AjayaDahal/inverted-pendulum/DESIGN.md

# Design

Every number here comes from `scripts/params.py` (geometry) and `parts/sim.json` (dynamics); the
gate (`scripts/check_parts.py`) checks them. Coordinates: x along the rails (+x = idler end, −x =
motor end), y from the front (−) to the back (+), z up from the desk; origin at the centre of the
frame's footprint.

## Key numbers

| | |
|---|---|
| Frame (yours) | 686 × 193 × 319 mm high (your tape and photos), 2020 posts and bottom members, 2040 top end bars on edge |
| Rails (yours) | 2 × 8 mm rods (680 mm or longer) on SK8 supports, 114 mm apart (calipers), axes 339 mm above the desk |
| Carriage | 4 × SC8UU under a 150 × 160 × 8 mm printed plate; 0.90 kg moving, belt and spinning parts included |
| Travel | ±241 mm to the bumpers (482 mm), limit switches trip at ±237, firmware keeps to ±231 |
| Belt | yours: HTD 8M, 20 mm, a closed loop of 175 teeth (1400 mm: your count, and its stamp); both pulleys 20 teeth (pitch Ø 50.93 mm, 160 mm per turn), axles 242 mm up, 620 mm apart |
| Belt length | the axles' spacing follows `BELT_TEETH`; the tensioner then takes 1380–1420 mm (±2.5 teeth); a loop over about 1500 mm (187 teeth) cannot fit inside the end frames |
| Motor | your NEMA 17 at 1.5 A and 19 V: 9.8 N at the cart up to 1 m/s (torque-speed model), 80 % of it relied on; 20.0 steps/mm at 1/16 microstep |
| Friction | rails 0.8 N, belt 0.3 N, greased idler 0.7 N at 15 N belt tension: 1.8 N at the cart; pivot: goal 0.5 mN m |
| Pivot | 8 mm × 115 mm shaft in 2 × KP08, 70 mm apart, axis 385 mm up; the arm turns 8 mm in front of the frame |
| Pendulum | 20 × 10 mm PLA arm, 300 mm from the axis to the tip; 112 g turning, CG 70 mm out, 1.71 × 10⁻³ kg m² about the axis |
| Sensor | AS5600 (12 bit) with a diametric magnet held 5 mm off the steel shaft's end, or a 600 P/R optical encoder |
| Control (model) | kick, swing-up, catch, LQR with integral action: upright in 3.1 s (≤ 4.8 s over 48 robustness runs), cart within ±187 mm; balanced, it hunts 0.1° at the pivot's goal friction |
| Firmware | `firmware/pendulum`: Arduino Uno / Nano or ESP32, FastAccelStepper, 200 Hz |
| Prints | 21 part files, 6 plates, no supports: PLA 364 g / 14.6 h, PETG 248 g / 10.1 h; only the parts you still need: `3mf/to_print_kobra_s1.3mf` |

## Measure first

Your measuring photos (tape and calipers) gave the frame's length and width, the rods' spacing
and the belt; you counted the belt's teeth and taped the frame's height. If any of it changes, put
it in `scripts/params.py`, then run `python scripts/build_all.py`; the gate re-checks every
clearance. The last four rows are catalogue sizes, not yet measured on your parts: measure them
before printing the parts that bolt to them (REPORT.md, R13):

| Name | What | Now | Source, and the slack in the design |
|---|---|---|---|
| `FRAME_H` | desk to the top of the top end bars | 319 | your tape, hook on the desk; everything is placed from the bars |
| `BELT_TEETH` | the closed belt's teeth | 175 | your count; it is stamped 1400 mm at 8 mm pitch. The axles' spacing follows, the tensioner takes ±2.5 teeth |
| `FRAME_L` | length between the end frames' outer faces | 686 | tape; the stops and switches follow it |
| `FRAME_W` | width across the posts' outer faces | 193 | tape; bridge slides ±10 mm: 173–213 wide fit |
| `ROD_SPACING` | rod centre to rod centre | 114 | calipers (122 over the rods' outer faces); SC8UU holes slotted ±8 mm: 98–130 fit |
| `ROD_L` | rod length | 680 | at least this, to reach through both SK8s |
| `BELT` | pitch and width | HTD 8M, 20 | calipers: 20.0–20.6 mm wide; its teeth 8 mm apart |
| `SC8UU` | one block's screw holes, centre to centre: along the rod, across it | 18, 24 (M4) | catalogue; your old plate's photo agrees. `carriage_plate`: fixed along the rod, ±8 mm across |
| `SK8`, `SC8UU` | rod centre above the end bar's top; the block's top face above the rod centre | 20, 11 | catalogue; they set the plate's height, so where the clamp's jaw meets the belt |
| `KP08` | bolt holes centre to centre; base to shaft centre | 42, 15 | catalogue. `pivot_bridge`: fixed M5 holes; the KP08's own slotted feet take a little |
| `ENDSTOP` | the limit-switch board's two holes, centre to centre | 19 | catalogue. `switch_mount`: ±1 mm |

## How the belt runs now

Cut on the belt plane: motor pulley at the left, idler at the right, the clamp column from the carriage down to the upper run

The belt is a vertical loop in **one plane, the frame's centre line (y = 0)**, round two equal
pulleys whose axles sit at the **same height (z 242)**, so both runs are level and parallel to the
rails, and the clamp grips the upper run in that same plane, under the carriage's centre (no twist
on the carriage). The pulleys hang from the 2040 top end bars, spaced for your closed loop:
`BELT_TEETH` sets the axles' spacing (620 mm for 175 teeth), so each sits 23 mm inboard of its end
frame's centre line, near where yours were.

**Motor end** (`motor_mount`, PETG). A saddle wraps the −x top end bar from below: a cheek on each
of its 40 mm faces (two M5 + T-nuts each) and a web under it, reaching in to the motor. The motor
hangs under the web, its
face on a 7 mm plate with the four M3 heads sunk 3.2 mm so the pulley's back flange (1 mm away)
clears them, between two side walls and on a floor: it cannot twist under belt pull. The shaft
points forward to the pulley; the body sits behind (+y), clear of the carriage.

**Pulleys** (`motor_pulley`, `idler_pulley`, PETG). 20 teeth, HTD 8M grooves (circular, 3.5 mm deep),
22 mm toothed width for the 20 mm belt, a 30 mm flange printed on each and a second flange
(`pulley_flange`) pressed on the front boss after assembly, so the belt has a flange on both sides
with 1 mm to spare. The motor pulley has a D bore whose flat faces a radial M3 × 12 set screw: its
head is sunk below the teeth, its nut captive in a slot under the front flange. Tighten it before
pressing the flange on. The idler turns on `idler_sleeve`.

**Idler end** (`idler_mount`, `idler_slider` × 2, PETG). The same saddle on the +x top end bar,
bolted through its outer cheek only (four M5 into T-nuts in the bar's outer slots). Its web reaches
in 29 mm to two cheeks either side of the idler, held by a 45° gusset from the saddle's inner
cheek, so the web prints (upside down) without supports. Each cheek has a window in which a slider
runs along x (its lower edge, printed last as a 32 mm bridge, has 1 mm of room for the bridge's
sag; the tension screw holds the slider at its height); the M4 × 50 axle passes slider – sleeve –
slider (an M5 × 50 fits too, once the sliders' holes and the sleeve's bore are drilled out to
5.2 mm). An M3 × 30 from an outboard lug
into each slider pulls it out. A closed loop cannot be tightened at the clamp: the idler does it,
and every millimetre the sliders move out takes up 2 mm of belt. Their ±10 mm of travel takes
loops of 1380–1420 mm (175 ± 2.5 teeth).

1. Grease the sleeve (a drop of any grease or oil: it is a plain bearing). Leave the axle nut
   finger-tight. Turn both tension screws evenly, a quarter turn at a time once the slack is out,
   until 100 g hung from the middle of the lower run pulls it down a further 10 mm (200 g: 20 mm).
   Measure from where the run hangs without the weight: its own weight already sags it about 4 mm.
   That is 15 N: enough, as the belt only has to stay taut under the motor's largest pull (~5 N
   each side); more only loads the idler's plain bearing, which the motor then has to drag
   (REPORT.md, P2).
2. Run the cart by hand from end to end. If the belt creeps towards one flange, give that side's
   screw a quarter turn more (the axle squares itself to the belt) and repeat.
3. Tighten the axle nut: it clamps the sliders' flanges against the cheeks. The sleeve takes the
   clamping, so the pulley still turns freely. Check the 100 g test again after the first hour of
   running, while the belt beds in.

**Clamp** (`belt_clamp` PLA, `clamp_jaw` PETG). The upper run is 81 mm below the carriage plate, so
the clamp is a box column (40 × 24 mm, 3 mm walls, flared into the jaw seat on all four sides: 45°
along the belt, 31° across) on four M3 × 16
from the plate's top. The belt lies in a 21 mm channel under a flat ceiling on its back; the jaw
comes up from below with HTD 8M tooth seats in phase with the belt's teeth (nearly 9 along its
70 mm) and pulls up on four M3 × 12 into nuts in the column's side walls. Your closed loop passes
straight through (an open belt would go in from both ends, about 30 mm each). Nothing slips and
there is no play between the cart and the belt.

**Lower run** passes 31 mm under the jaw's screw heads. The cart never reaches the pulleys: the
SC8UU blocks stop on the bumpers first.

## Carriage

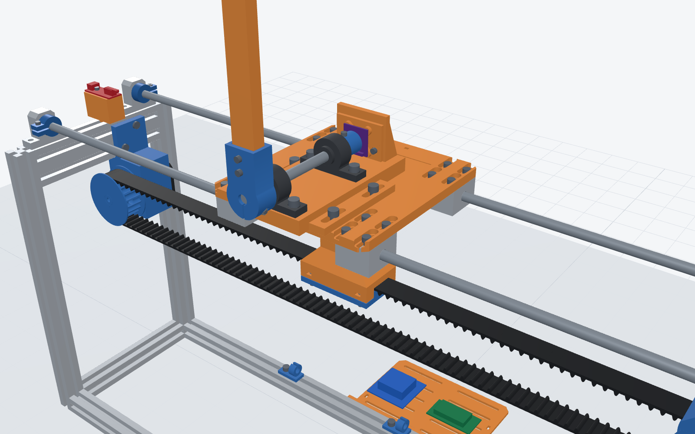
[picture p12: renders/08_carriage.png]
Carriage: plate on four SC8UU blocks, the pivot bridge with both KP08s, the sensor tower, the hub and arm in front


- `carriage_plate` (PLA, 8 mm): four SC8UU blocks underneath (16 × M4 × 10, heads sunk; holes
  slotted ±8 mm in y so the plate fits rods 98–130 mm apart without binding: set the blocks on the
  rods, then tighten). Four M5 nuts in pockets underneath take the bridge; four M3 counterbores take
  the clamp. Two zip-tie bridges at the back edge hold the sensor lead. It is nearly square: the
  lines engraved in its top face go over the rods and its arrow points to the front.
- `pivot_bridge` (PLA): carries both KP08s in line (4 × M5 × 16, nuts in pockets underneath), the
  front one over the plate's front edge. Its side flanges are slotted ±10 mm (4 × M5 × 20): slide it
  until the arm turns 8 mm in front of the frame's front face. At its back end the 5 mm **sensor
  tower** stands on the shaft's axis.

## Pendulum

- Shaft: 8 mm × 115 mm steel, through both KP08s (their set screws hold it) into the hub.
- `pendulum_hub` (PETG): split below the bore, one M3 × 20 pinch screw; the arm in a 25 mm socket
  with 2 × M3 × 20 through. The socket's front face prints as a bridge, so it stands 0.8 mm off the
  arm (0.2 elsewhere), room for that bridge's sag: the two screws pull it onto the arm.
- `pendulum_arm` (PLA, prints diagonally): 20 × 10 mm, its 20 mm in the plane it swings in;
  `pendulum_tip` caps it (M3 × 20 pin; room for washers if you want more tip mass: re-run `sim.py`
  with the new mass).
- It turns a full circle at every cart position: the hub, arm and tip stay in front of the frame
  (y −118 to −100) and the tip clears the desk by 83 mm when it hangs (gate: `pendulum`).
- **Pivot friction** decides how still it balances. While the pivot's bearings stick, the pendulum
  moves with the cart, so a balanced pendulum hunts once the pivot's friction passes about
  0.5 mN m: 0.9° and 17 mm peak to peak at 1 mN m, 4° and 88 mm at 2.5 (REPORT.md, P16). The
  swing-up copes with up to 2.5 mN m; the goal is 0.5 mN m (0.1°, 2 mm). Two KP08 inserts with
  rubber seals are often 1-2 mN m, so before the first run:
  - free the inserts: pry the seals off (a small screwdriver under the lip), wash the grease out
    with isopropyl alcohol, one drop of light oil;
  - loosen the KP08 bolts and re-tighten them with the shaft turning (the two blocks in line);
    the set screws must not push the shaft off-centre;
  - measure with the firmware's `f` test (lift the pendulum 30-40°, let go): it prints the
    friction and the hunting to expect, and re-centres hanging on the true vertical. By eye,
    0.5 mN m is about 20 full swings from 30° before it stops; 2.5 mN m, 4.
- **Keep clear:** the arm sweeps a 600 mm circle in front of the frame at any cart position: x
  ±544 mm, 63 to 670 mm above the desk, and its tip reaches 4 m/s. Nothing in that disc while it
  runs; keep the power switch in reach.

## Angle sensor

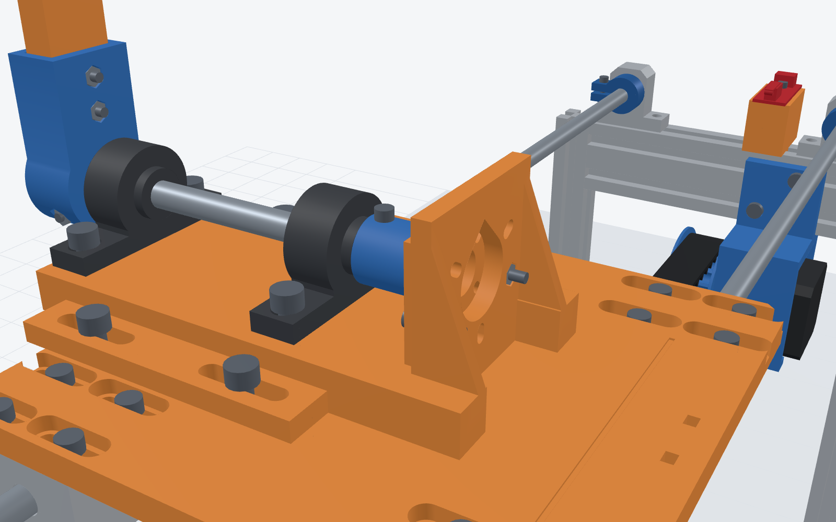
[picture p13: renders/09_sensor.png]
Sensor tower: the AS5600 board on its adapter, facing the magnet cap on the shaft's end


**AS5600 (default).** `magnet_cap` (PETG) goes on the shaft's back end (M3 × 8 set screw) with the
6 × 2.5 mm diametric magnet glued in its pocket, on the axis, 5 mm of plastic away from the
shaft's end: steel close behind the magnet pulls its field in, and the reading gets weaker and
less linear (REPORT.md, P7). `as5600_mount` (PLA) bolts to the
tower's front face (2 × M3 × 12, nuts in the tower's back) and carries the board on four raised,
slotted pads (M2.5 self-tapping, or M3, in the board's corner holes, 18–26 mm apart), chip
towards the magnet, 1.5 mm air gap. Solder its header facing forward (or use the side pads), and
tie its DIR pin to GND: left floating on some boards, it flips the angle's direction at random.

**600 P/R optical encoder (option).** Leave out the cap and the adapter; bolt the encoder to the
tower's back face (3 × M3 into its holes on a 28–32 mm circle, its boss through the tower's
window) and join the shafts with `coupler` (PETG, slotted beam coupling: it takes up the
misalignment between the KP08s and the encoder's bearings). The viewer's "optical encoder" button
shows it.

## Travel ends and homing

`rod_bumper` collars (4, PETG, M3 × 12 clamp) sit against the SK8s' inner faces (further in, if a
short belt brings the pulleys in): the SC8UU blocks stop on them at ±241 mm. A `switch_mount` on
each top end bar (one M5 into a T-nut, keyed in the bar's top slot, inboard of the SK8) holds a
mechanical endstop level with the plate; its roller trips at ±237 mm.

Homing: move −x slowly to the −x switch, back off 5 mm, set x = −232 (the trip point plus the
back-off); then centre. Keep the controller within ±231 mm.

## Control

The model (`scripts/sim.py`) is the cart-pole of this machine: cart 0.68 kg + belt 0.18 kg + motor
rotor and pulleys 0.03 kg reflected = 0.90 kg; pendulum 112 g with its CG 70 mm from the axis and
1.71 × 10⁻³ kg m² about it (sliced masses, steel shaft, screws). Natural frequency 6.7 rad/s. The
firmware runs the same controller (`firmware/pendulum/controller.h`, line for line: the gate
replays simulated runs through it and requires the same commands).

- **Input = cart acceleration,** at most 3.54 m/s², speed at most 1 m/s. A stepper sets motion,
  not force: the force each run needs (the motion plus 1.8 N of friction at the cart) is checked
  at every step against the motor's torque-speed curve at 1.5 A and 19 V (9.8 N up to 1 m/s),
  80 % of it relied on. The margin never falls below 0.68 N.
- **Start:** when the pendulum has rested near hanging for 0.25 s, a kick: 3.54 m/s² for 135 ms
  one way, then the other.
- **Swing-up:** the cart's speed is set to
  v = −0.655 tanh(3.32 (E − E_ref)/(m g l)) tanh(13.0 sin(θ + 0.085 θ̇)) m/s, fading to nothing
  near the travel ends, and tracked with u = 6.0 (v − ẋ) − 22.7 x. Its acceleration then pumps
  energy in like the classic law (it follows −θ̇ cos θ), while the cart's speed and travel stay
  bounded. E_ref is 0.102 m g l above the upright rest energy, to make up for pivot friction.
- **Catch:** within 37.6° of upright while θ + θ̇/ω₀ is under 0.145 rad: the pendulum is coasting
  into the top, so little is left to correct and the cart does not saturate.
- **Balance:** LQR with integral action on [x, ẋ, θ, θ̇, ∫x] (θ = 0 up, positive towards +x),
  Q = diag(24.4, 374, 379, 4.50, 3.83), R = 0.273: **u = −K s, K = [−20.4, −43.9, −147.1, −21.7,
  −3.74]** (SI units, u in m/s²), on the state predicted over the 4 commands (20 ms) still on their
  way to the motor. The integral takes up an error in the upright calibration. Back to the
  swing-up past 45°.
- **Rate:** θ̇ from successive readings through a first-order filter (α = 0.55 per 5 ms). One
  AS5600 count in a period reads as 0.31 rad/s, so the command ripples while it balances (about
  1.4 m/s² RMS, 7 N peak to peak at the belt): a hum, inside the force budget (the plot below).
- **Pivot friction:** balanced, the pivot's stick-slip makes the pendulum hunt once its friction
  passes about 0.5 mN m: 0.1° and 2 mm peak to peak at 0.5 mN m, 0.9° and 17 mm at 1, 4.1° and
  88 mm at 2.5. Stiff angle and speed gains put that onset late (the first controller hunted
  1.2°, 2.8° and 7.2° there); an observer and friction compensation hardly change it. The pivot
  has a goal, 0.5 mN m, the gate holds the hunting there to 1° and 15 mm, and the firmware's `f`
  test measures the real pivot ("Pendulum").
- **Result:** from hanging still at the goal friction, upright in 3.1 s, the cart within ±144 mm.
  It must work on 48 robustness runs: pendulum mass and inertia ±20 %, CG ±15 %, cart +20 %; delay
  from the angle reading to the motor 8–20 ms; pivot friction 0–2.5 mN m; upright error ±1°;
  AS5600 or the 600 P/R encoder; each run from hanging still, with a 0.7 rad/s push once it
  balances. Every run swings up by 4.8 s, holds and recovers, the cart within ±187 mm of ±231. On
  260 random scenarios none was tuned on, all 260 did (cart within ±190 mm).

Simulated run from hanging still: kick, swing-up, catch, push; pendulum angle, cart position, force needed and available

## Electronics and firmware

`electronics_tray` (PLA) lies on the desk behind the frame, hooked to the back long member (2 ×
M5 into T-nuts in its outer slot), with M3 slots for the stepper-driver carrier and the
controller and zip-tie slots. Run the motor and switch leads along the frame in `cable_clip`s
(M5 + T-nut into any slot). Take the sensor lead from the carriage's zip-tie bridges up and over in
a loose loop to the tray: allow 400 mm of slack for the full travel.

| Wiring | Arduino Uno / Nano | ESP32 |
|---|---|---|
| Driver STEP / DIR / EN | 9 / 8 / 7 (STEP on 9 or 10 only) | 25 / 26 / 27 |
| Limit switches −x / +x, normally closed to GND | 4 / 5 | 32 / 33 |
| AS5600 SDA / SCL | A4 / A5 (board on 5 V) | 21 / 22 (board on 3.3 V) |
| or the 600 P/R encoder A / B | 2 / 3 | 18 / 19 |

- **Driver:** 1.5 A, 1/16 microstepping (A4988: MS1-MS3 high), its heatsink on, and a 47-100 µF
  capacitor across its motor supply if the carrier has none. Set the current with Vref: A4988
  Vref = 8 × R_sense × 1.5 A, so 0.82 V with 0.068 Ω sense resistors and 1.2 V with 0.1 Ω (read
  yours); DRV8825 0.75 V. Below about 1.3 A the motor runs short of force (REPORT.md, P1).
- **Supply:** the 19 V laptop brick. At 12 V the motor loses force above ~0.8 m/s.
- **Switches** wired normally closed: a broken wire then reads as pressed and stops the cart.
- **Sensor lead:** SDA and SCL each twisted with a ground, away from the motor wires; over about
  30 cm, set `I2C_HZ` to 100000 at the top of `pendulum.ino`.
- **Firmware:** `firmware/pendulum` (Arduino IDE or arduino-cli; library FastAccelStepper from the
  Library Manager). It builds for the Uno, Nano and ESP32. `config.h` is generated from this
  design (`scripts/make_firmware.py`); your wiring and the two direction settings are at the top
  of `pendulum.ino`. An STM32 board does not run FastAccelStepper.

**First power-on** (serial monitor at 115200; one letter per command, `?` lists them):

1. `i`: both switches read ok; press each by hand and it reads PRESSED.
2. `m`: the sensor report: magnet found, AGC mid-range; turn the pendulum by hand and the angle
   follows. Any key stops the report.
3. Clamp the frame to the desk (REPORT.md, P11). Pendulum hanging, nothing in its circle.
4. `h`: homes slowly to the −x switch. If it heads for +x instead, it stops at that switch and
   tells you to set `DIR_HIGH_MOVES_PLUS` to false.
5. `c`: with the pendulum hanging still: this is its zero, every session.
6. `d`: nudges the cart and checks the angle's direction; if it is reversed it says so (set
   `ANGLE_SIGN` to -1) and uses the right one until reset.
7. `f`: lift the pendulum 30-40° and let go. It prints the pivot's friction (goal 0.5 mN m) and the
   hunting to expect, and re-centres hanging on the true vertical. Over 2.5 mN m, free the pivot
   first ("Pendulum").
8. `r`: kicks, swings up and balances. `s` stops; `t` streams telemetry (ms, x mm, v mm/s, angle,
   command, mode) to plot. It stops by itself on a limit switch, past the soft limit, or when
   the sensor fails to answer.

## Assembly order

1. **Print** `petg_1_belt_drive` (the frame is measured, above) and check the saddles on the bars.
2. **Motor end.** Drop four T-nuts into the −x top end bar's 40 mm faces, slide the saddle up under
   the bar, bolt it (M5 × 10). Motor into the U from behind, four M3 × 8 from the front.
3. **Motor pulley.** M3 nut into its slot, pulley onto the shaft with the screw on the flat, axles
   flush; tighten. Leave its front flange off: the closed belt goes on over the front first.
4. **Idler end.** Four T-nuts into the +x top end bar's outer face, the saddle up under the bar,
   four M5 × 10 through its outer cheek. Sliders into the cheeks' windows, tension screws
   in from the lugs a few turns only, so the sliders sit fully in (the most slack). Idler: sleeve
   into the pulley, front flange on. Leave the axle out: the belt must go round the pulley first.
5. **Carriage.** SC8UU blocks on the rods; plate on them, its engraved lines over the rods and its
   arrow to the front, so the slots run across the rods (M4 × 10, loose); slide the cart end to end
   and tighten the screws with the blocks parallel. It must then run end to end with a light push
   and not tighten anywhere: if it binds near one end, the rods are not parallel; move an SK8
   (REPORT.md, P13). Bumpers on the rods against the SK8s.
6. **Belt and clamp.** Nuts into the column's flange pockets and side slots; column under the plate
   (4 × M3 × 16 from the top). The idler pulley inside the belt loop, held between the cheeks;
   the M4 × 50 through slider – sleeve – slider, nut finger-tight (the cheeks, the web and the
   axle make a ring the belt passes through, so the axle goes in after the belt). The loop's other
   end onto the motor pulley from the front, then its front flange on (a drop of CA). Upper run
   into the clamp's channel, teeth in the seats, jaw up from below (4 × M3 × 12). An open belt:
   both ends in the channel.
7. **Tension** (above).
8. **Pivot.** M5 nuts into the bridge's pockets; KP08s on (M5 × 16); bridge on the plate (M5 × 20,
   washers), slid so the arm will turn 8 mm in front of the frame. Shaft through both KP08s, hub on
   its front end, magnet cap on its back end; KP08 set screws, then the hub's pinch screw. Arm into
   the hub (2 × M3 × 20), tip on.
9. **Sensor.** AS5600 on the adapter, adapter on the tower, 1.5 mm from the magnet. Free the pivot
   ("Pendulum", pivot friction).
10. **Switches, tray, clips, leads.** Then the first power-on ("Electronics and firmware").
