AjayaDahal/inverted-pendulum/renders/02_front.png

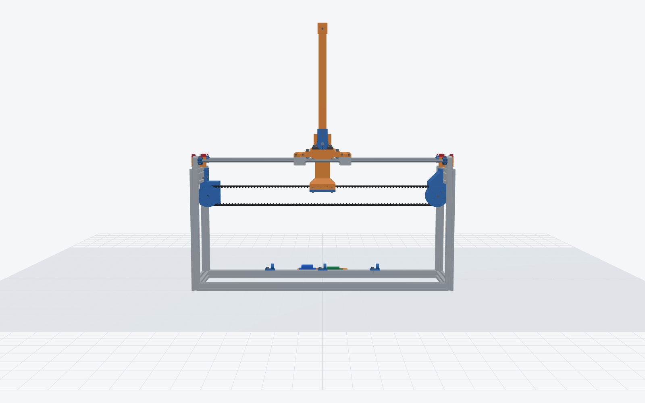
renders/02_front.png
