AjayaDahal/inverted-pendulum/renders/03_end.png

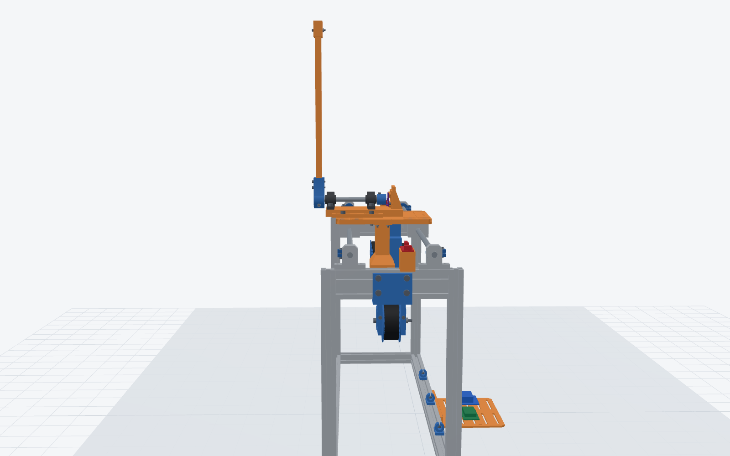
renders/03_end.png
