AjayaDahal/inverted-pendulum/renders/04_top.png

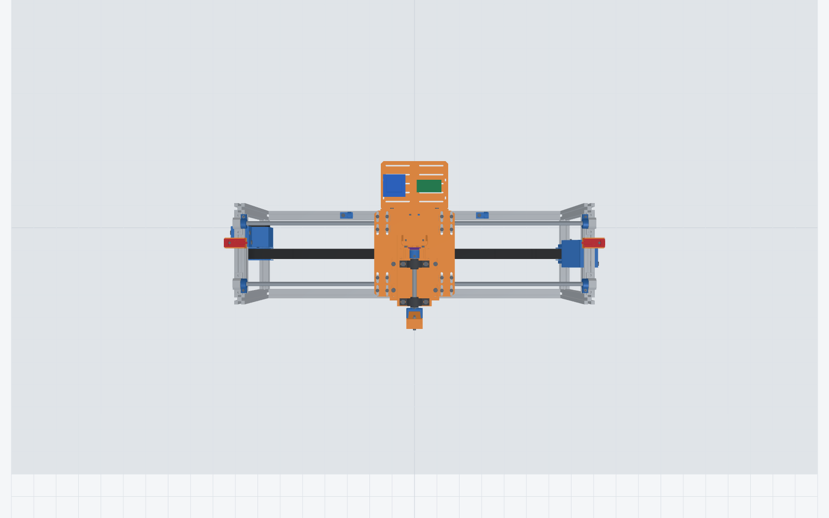
renders/04_top.png
