AjayaDahal/inverted-pendulum/renders/06_motor_end.png

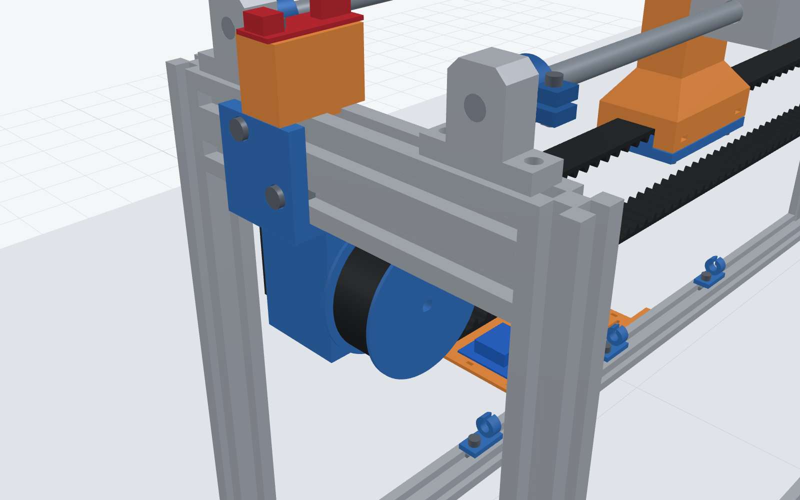
renders/06_motor_end.png
