AjayaDahal/inverted-pendulum/renders/07_idler_end.png

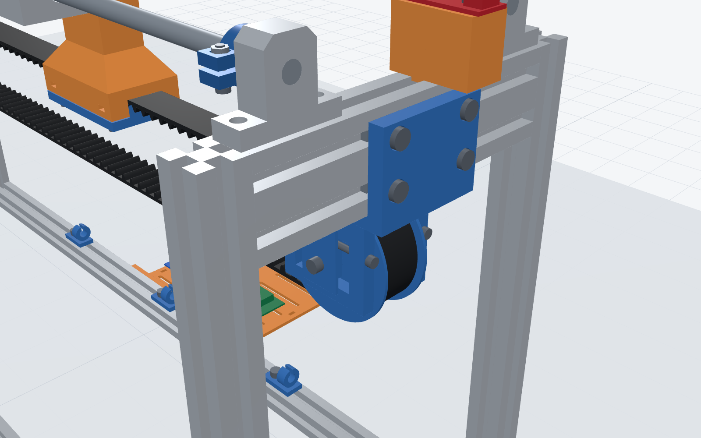
renders/07_idler_end.png
