AjayaDahal/inverted-pendulum/BOM.md

# Bill of materials

Quantities for one machine, generated by `scripts/make_bom.py` from the design (do not edit by
hand). Nothing new to buy: the bought parts are the ones already on the machine (or its
drawer), and the fasteners are plain M3, M4 and M5 screws with 20-series T-nuts. Masses and
print times are in [`tracker.md`](tracker.md); where each part goes, in [`DESIGN.md`](DESIGN.md).

## Printed parts

21 part files, 29 pieces, on 6 plates (`coupler` only with the optical encoder).

| Part | Qty | Material | Plate | What it does |
|---|---|---|---|---|
| `carriage_plate` | 1 | PLA | 3 `pla_1_carriage_plate` | carriage plate on the four SC8UU blocks |
| `pivot_bridge` | 1 | PLA | 4 `pla_2_bridge_clamp_tray` | pivot bridge: both KP08s in line, pendulum in front of the frame, sensor tower |
| `as5600_mount` | 1 | PLA | 4 `pla_2_bridge_clamp_tray` | AS5600 adapter on the sensor tower |
| `belt_clamp` | 1 | PLA | 4 `pla_2_bridge_clamp_tray` | belt clamp: stiff column from the carriage down to the belt's upper run |
| `clamp_jaw` | 1 | PETG | 1 `petg_1_belt_drive` | clamp jaw: HTD 8M tooth seats under the belt |
| `motor_mount` | 1 | PETG | 1 `petg_1_belt_drive` | motor mount: NEMA 17 under the -x top end bar, pulley on the belt plane |
| `motor_pulley` | 1 | PETG | 2 `petg_2_pulleys_pivot` | HTD 8M 20T pulley on the motor shaft (set screw on the flat) |
| `idler_pulley` | 1 | PETG | 2 `petg_2_pulleys_pivot` | HTD 8M 20T idler on its sleeve |
| `pulley_flange` | 2 | PETG | 2 `petg_2_pulleys_pivot` | front flange, pressed on each pulley's boss |
| `idler_mount` | 1 | PETG | 1 `petg_1_belt_drive` | idler mount: saddle on the +x top end bar, cheeks with slider windows |
| `idler_slider` | 2 | PETG | 1 `petg_1_belt_drive` | axle slider: tension screw pulls it out, flange locks it |
| `idler_sleeve` | 1 | PETG | 1 `petg_1_belt_drive` | sleeve the idler turns on |
| `rod_bumper` | 4 | PETG | 1 `petg_1_belt_drive` | rod collar: hard stop for the SC8UU blocks |
| `switch_mount` | 2 | PLA | 4 `pla_2_bridge_clamp_tray` | limit-switch block on each top end bar |
| `pendulum_hub` | 1 | PETG | 2 `petg_2_pulleys_pivot` | pendulum hub: clamps the shaft, holds the arm |
| `pendulum_arm` | 1 | PLA | 5 `pla_3_arm` | pendulum arm, 300 mm from the pivot to the tip |
| `pendulum_tip` | 1 | PLA | 5 `pla_3_arm` | tip cap (room for washers as tip mass) |
| `magnet_cap` | 1 | PETG | 2 `petg_2_pulleys_pivot` | magnet cap: AS5600 magnet on the shaft's axis |
| `coupler` | 1 | PETG | 6 `petg_3_option_encoder` | option: flexible coupling to a 600 P/R optical encoder (instead of the magnet cap) |
| `electronics_tray` | 1 | PLA | 4 `pla_2_bridge_clamp_tray` | electronics tray behind the frame |
| `cable_clip` | 3 | PETG | 1 `petg_1_belt_drive` | cable clip for any slot of the frame |

## Bought parts (already on the machine)

| Item | Qty | Notes |
|---|---|---|
| 2020 / 2040 aluminium profile | 10 | the frame as built: 4 posts, 2 top end bars (2040 on edge), 2 bottom end bars, 2 long members, 686 x 193 x 319 mm (your photos and tape) |
| 8 mm rod | 2 | 680 mm or longer, 114 mm apart (98-130 fit) |
| SK8 rod support | 4 | on the top end bars, as built |
| SC8UU bearing block | 4 | under the carriage plate, 4 x M4 x 10 each |
| KP08 pillow block | 2 | on the pivot bridge, in line, 70 mm apart |
| 8 mm pivot shaft, 115 mm | 1 | steel: an offcut of 8 mm rod or the plain shank of an M8 bolt (the KP08 set screws need steel) |
| 6 x 2.5 mm diametric magnet | 1 | diametrically magnetised; most AS5600 boards come with one |
| AS5600 magnetic encoder board | 1 | corner holes 18-26 mm apart |
| optional: 600 P/R optical encoder | 1 | instead of the AS5600: 38 mm body, 6 mm shaft, M3 on a 28-32 mm circle |
| NEMA 17 stepper | 1 | 0.40 N m holding or more (17HS4401 class), 1/16 microstepping |
| mechanical endstop | 2 | lever switch on a 40 x 16 mm board, holes 19 mm apart; wired normally closed |
| stepper driver carrier (A4988 / DRV8825) | 1 | step/dir driver set to 1.5 A, with its heatsink |
| controller (Arduino Uno / Nano or ESP32) | 1 | runs firmware/pendulum (FastAccelStepper: not an STM32) |
| HTD 8M belt, 20 mm wide | 1 | yours: a closed loop of 175 teeth (1400 mm, your count; the tensioner takes 1380-1420) |

## Fasteners

114 pieces, each checked by the gate for length against what it clamps (`scripts/hardware.py`, check `bolts`).

| Fastener | Qty | Where |
|---|---|---|
| M3 x 8 | 9 | `motor_mount`, `switch_mount`, `magnet_cap` |
| M3 x 12 | 11 | `clamp_jaw`, `motor_pulley`, `rod_bumper`, `as5600_mount` |
| M3 x 16 | 4 | `belt_clamp` |
| M3 x 20 | 4 | `pendulum_hub`, `pendulum_tip` |
| M3 x 30 | 2 | `idler_mount` |
| M4 x 10 | 16 | `carriage_plate` |
| M4 x 50 | 1 | `idler_slider` |
| M5 x 10 | 13 | `motor_mount`, `idler_mount`, `electronics_tray`, `cable_clip` |
| M5 x 12 | 2 | `switch_mount` |
| M5 x 16 | 4 | `pivot_bridge` |
| M5 x 20 | 4 | `pivot_bridge` |
| M3 nut | 20 | `belt_clamp`, `clamp_jaw`, `motor_pulley`, `rod_bumper`, `pendulum_hub`, `pendulum_tip`, `magnet_cap`, `as5600_mount` |
| M4 nut | 1 | `idler_slider` |
| M5 nut | 8 | `pivot_bridge` |
| T-nut M5, 20-series | 15 | `motor_mount`, `idler_mount`, `switch_mount`, `electronics_tray`, `cable_clip` |
| M5 washer | 4 | under the `pivot_bridge` bolts' heads (slotted flanges) |

**Not drawn in the model** (small, from the drawer):

- 4 x M2.5 x 6 self-tapping screws (or M3) for the AS5600 board on its adapter.
- M3 screws or standoffs for the driver carrier and the controller on the tray (their slots take M3).
- Optical-encoder option: 3 x M3 x 6 into the encoder's face.
- CA glue (pulley flanges, the magnet in its cap), zip ties (sensor lead, tray), medium thread
  locker for the pulley's set screw (optional), a drop of grease or oil for the idler's sleeve.
- A 47-100 uF electrolytic capacitor across the driver's motor supply, if the carrier has none.
- Arduino IDE (or arduino-cli) with the FastAccelStepper library, to load `firmware/pendulum`.

**To confirm before printing:** that the drawer holds the 15 T-nuts, the M4 x 50 idler axle
and an 8 mm x 115 mm steel shaft.
