AjayaDahal/inverted-pendulum/3mf/complete_project_kobra_s1.3mf

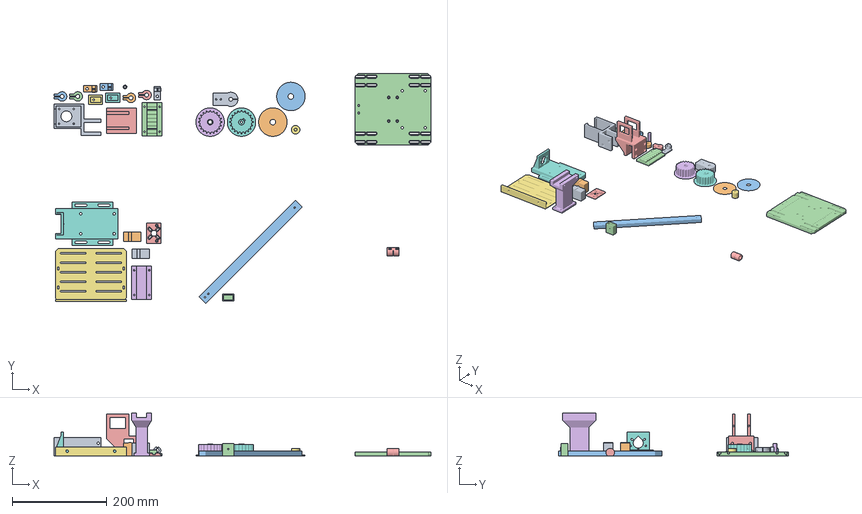
[picture p19: CAD file, 2026-11-11]
3mf/complete_project_kobra_s1.3mf
793.8 x 483.5 x 90.1 mm
cable_clip_1.stl
cable_clip_2.stl
cable_clip_3.stl
clamp_jaw.stl
idler_mount.stl
idler_sleeve.stl
idler_slider_1.stl
idler_slider_2.stl
motor_mount.stl
rod_bumper_1.stl
rod_bumper_2.stl
rod_bumper_3.stl
rod_bumper_4.stl
idler_pulley.stl
magnet_cap.stl
motor_pulley.stl
pendulum_hub.stl
pulley_flange_1.stl
pulley_flange_2.stl
carriage_plate.stl
as5600_mount.stl
belt_clamp.stl
electronics_tray.stl
pivot_bridge.stl
switch_mount_1.stl
switch_mount_2.stl
pendulum_arm.stl
pendulum_tip.stl
coupler.stl
