AjayaDahal/inverted-pendulum/3mf/s1_petg/clamp_jaw.3mf

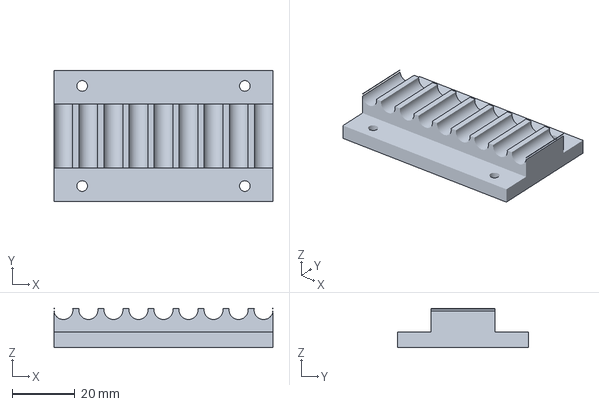
[picture p20: CAD file, 2026-11-10]
3mf/s1_petg/clamp_jaw.3mf
70.0 x 42.0 x 12.5 mm
