AjayaDahal/inverted-pendulum/3mf/s1_petg_plates/petg_3_option_encoder.3mf

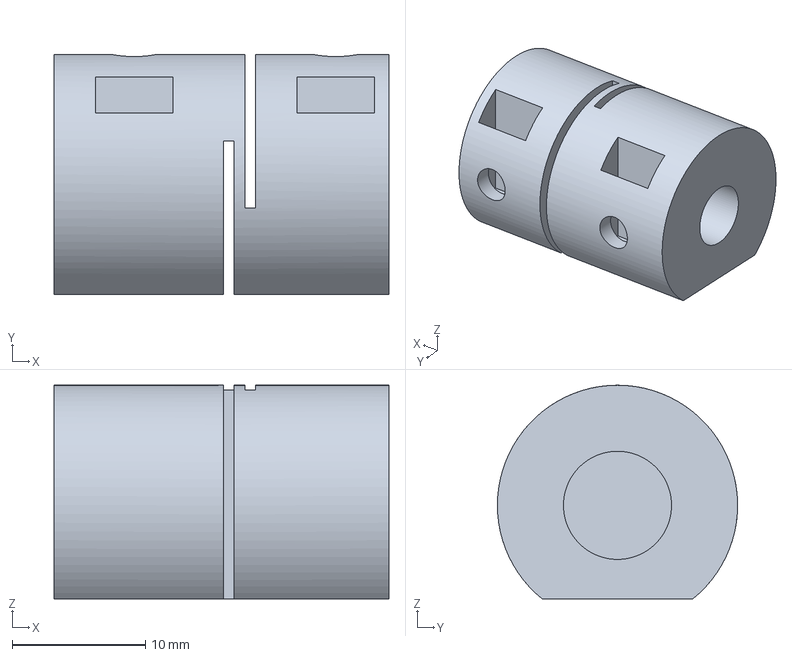
[picture p21: CAD file, 2026-11-10]
3mf/s1_petg_plates/petg_3_option_encoder.3mf
25.1 x 18.0 x 16.0 mm
