AjayaDahal/inverted-pendulum/3mf/s1_pla/carriage_plate.3mf

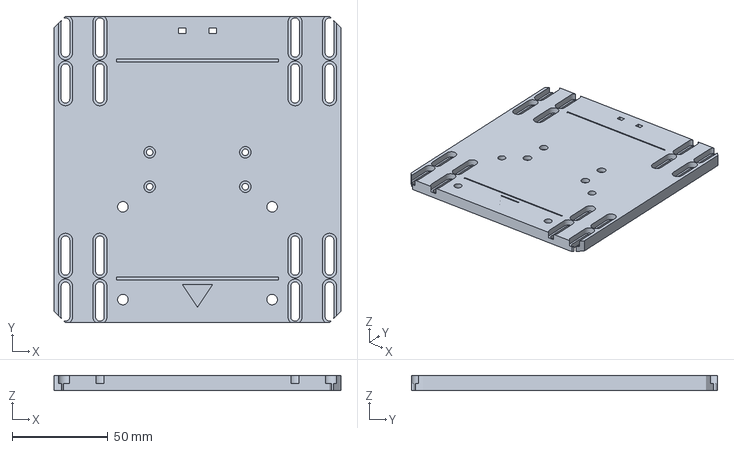
[picture p22: CAD file, 2026-11-11]
3mf/s1_pla/carriage_plate.3mf
150.0 x 160.0 x 8.00 mm
