AjayaDahal/inverted-pendulum/parts/inverted_pendulum_v1.step

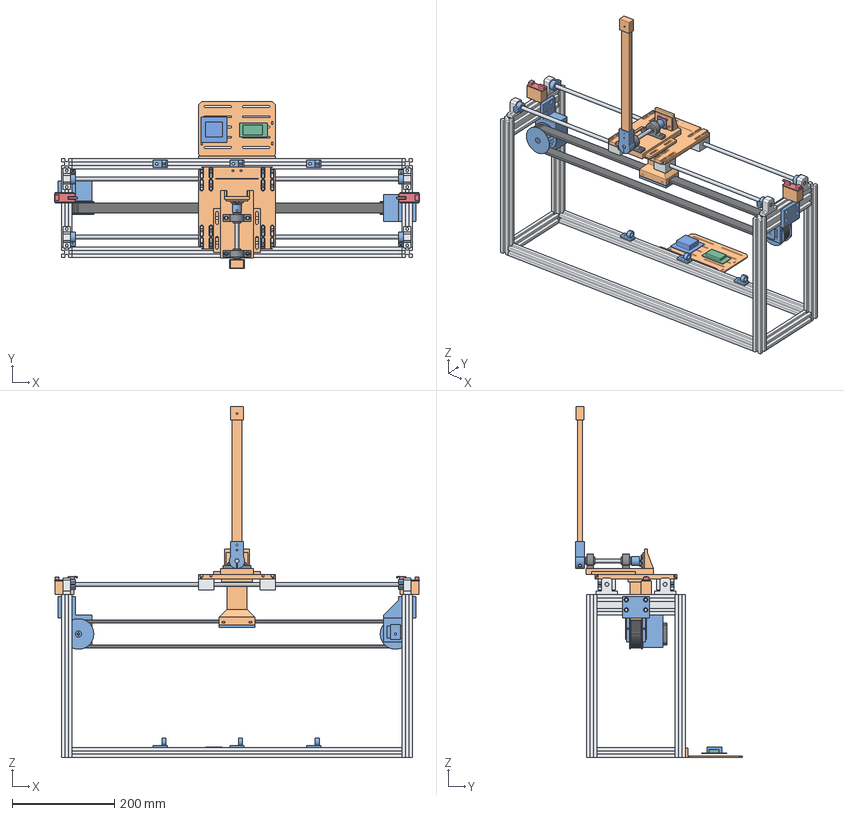
[picture p23: CAD file, 2026-11-11]
parts/inverted_pendulum_v1.step
714.0 x 327.0 x 687.4 mm
carriage_plate
pivot_bridge
as5600_mount
belt_clamp
clamp_jaw
motor_mount
motor_pulley
idler_pulley
pulley_flange_2 x 2
idler_mount
idler_slider_2 x 2
idler_sleeve
rod_bumper_4 x 4
switch_mount_2 x 2
pendulum_hub
pendulum_arm
pendulum_tip
magnet_cap
electronics_tray
cable_clip_3 x 3
post_mf
post_mb
top_bar_m
bottom_bar_m
post_pf
post_pb
top_bar_p
bottom_bar_p
long_f
long_b
rod_f
sk8_mf
sc8uu_mf
sk8_pf
sc8uu_pf
rod_b
sk8_mb
sc8uu_mb
sk8_pb
sc8uu_pb
kp08_front
kp08_rear
pivot_shaft
magnet
as5600
nema17
endstop_m
endstop_p
driver_board
controller
belt
