AjayaDahal/inverted-pendulum/parts/vitamins/rod_f.stl

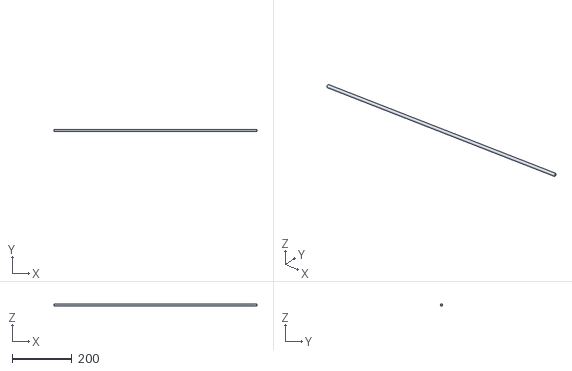
[picture p24: CAD file, 2026-11-08]
parts/vitamins/rod_f.stl
680.0 x 8.00 x 8.00
