AjayaDahal/inverted-pendulum/3mf/s1_petg/idler_pulley.3mf

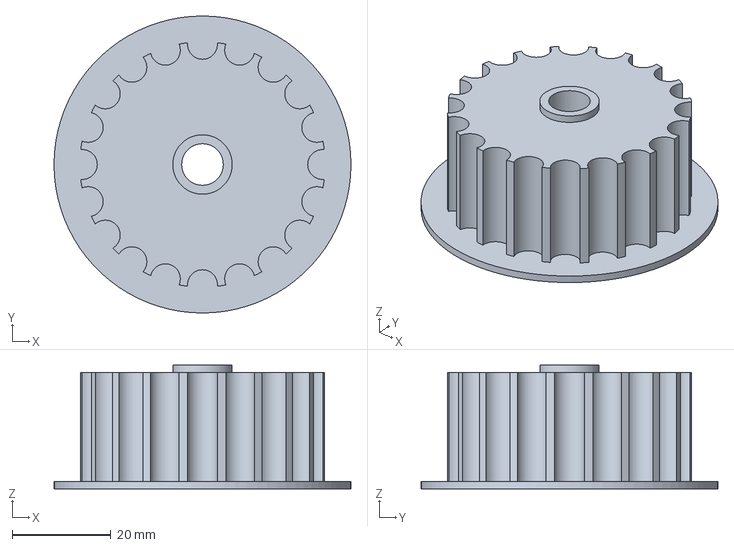
[picture p25: CAD file, 2026-11-10]
3mf/s1_petg/idler_pulley.3mf
60.0 x 60.0 x 25.0 mm
