AjayaDahal/inverted-pendulum/3mf/s1_petg_plates/petg_1_belt_drive.3mf

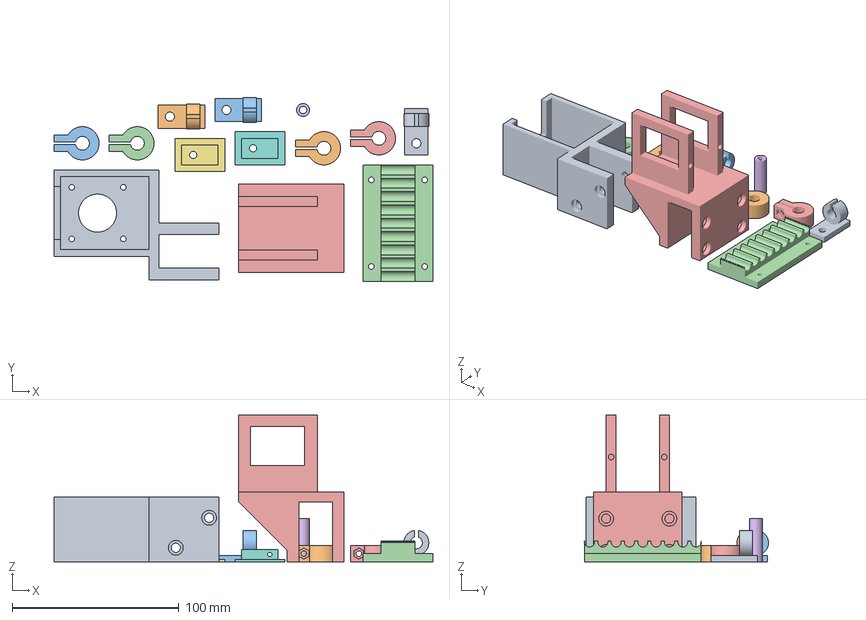
[picture p26: CAD file, 2026-11-10]
3mf/s1_petg_plates/petg_1_belt_drive.3mf
227.6 x 110.5 x 88.2 mm
cable_clip_1.stl
cable_clip_2.stl
cable_clip_3.stl
clamp_jaw.stl
idler_mount.stl
idler_sleeve.stl
idler_slider_1.stl
idler_slider_2.stl
motor_mount.stl
rod_bumper_1.stl
rod_bumper_2.stl
rod_bumper_3.stl
rod_bumper_4.stl
