AjayaDahal/inverted-pendulum/3mf/s1_pla/pendulum_arm.3mf

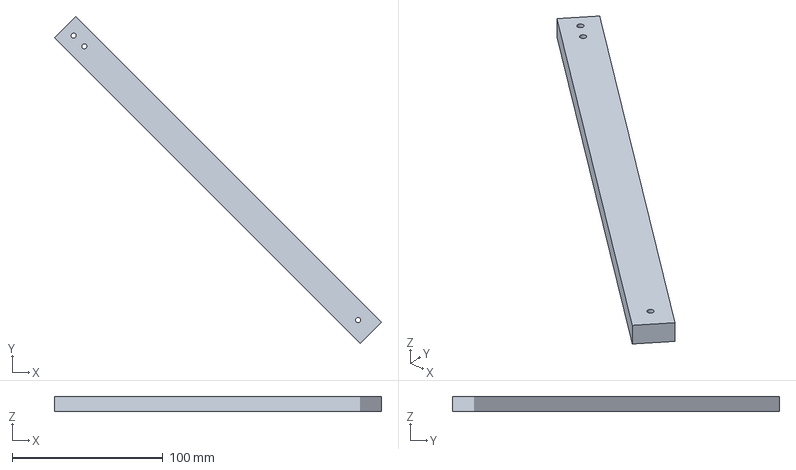
[picture p27: CAD file, 2026-11-10]
3mf/s1_pla/pendulum_arm.3mf
217.1 x 217.1 x 10.0 mm
