AjayaDahal/inverted-pendulum/3mf/s1_pla_plates/pla_2_bridge_clamp_tray.3mf

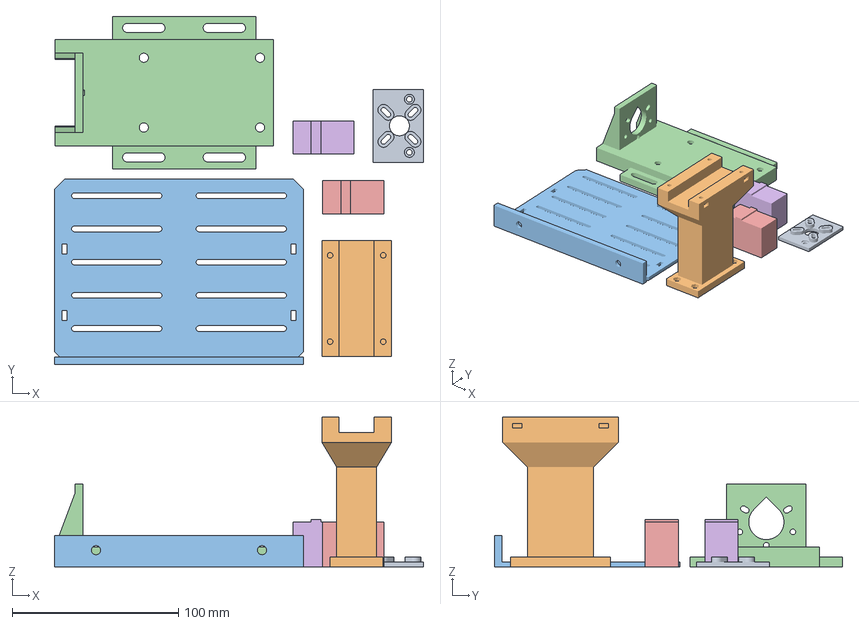
[picture p28: CAD file, 2026-11-10]
3mf/s1_pla_plates/pla_2_bridge_clamp_tray.3mf
222.2 x 209.9 x 90.1 mm
as5600_mount.stl
belt_clamp.stl
electronics_tray.stl
pivot_bridge.stl
switch_mount_1.stl
switch_mount_2.stl
