AjayaDahal/inverted-pendulum/3mf/to_print_kobra_s1.3mf

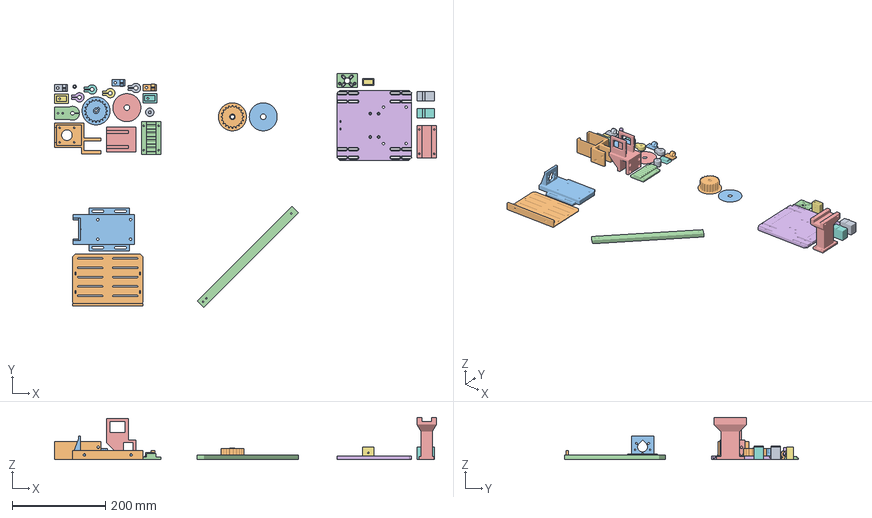
[picture p29: CAD file, 2026-11-11]
3mf/to_print_kobra_s1.3mf
818.0 x 501.7 x 90.1 mm
cable_clip_1.stl
cable_clip_2.stl
cable_clip_3.stl
clamp_jaw.stl
idler_mount.stl
idler_sleeve.stl
idler_slider_1.stl
idler_slider_2.stl
magnet_cap.stl
motor_mount.stl
motor_pulley.stl
pendulum_hub.stl
pulley_flange.stl x 2
rod_bumper_1.stl
rod_bumper_2.stl
rod_bumper_3.stl
rod_bumper_4.stl
idler_pulley.stl
as5600_mount.stl
belt_clamp.stl
carriage_plate.stl
pendulum_tip.stl
switch_mount_1.stl
switch_mount_2.stl
electronics_tray.stl
pivot_bridge.stl
pendulum_arm.stl
