AjayaDahal/inverted-pendulum/parts/assembly/motor_mount.stl

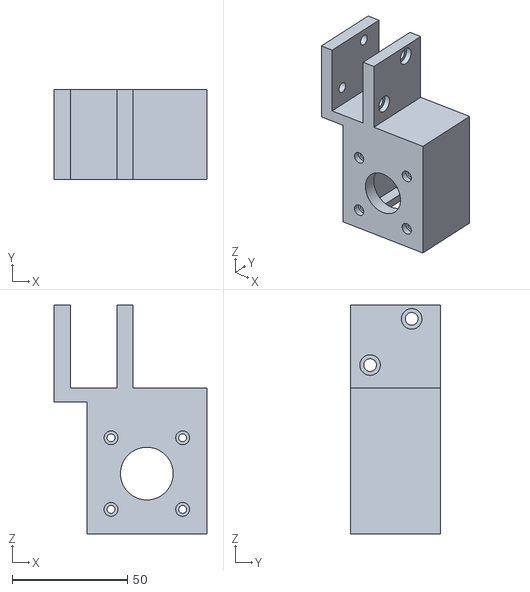
[picture p30: CAD file, 2026-11-10]
parts/assembly/motor_mount.stl
66.1 x 39.0 x 99.1
