AjayaDahal/inverted-pendulum/parts/print_ready/belt_clamp.stl

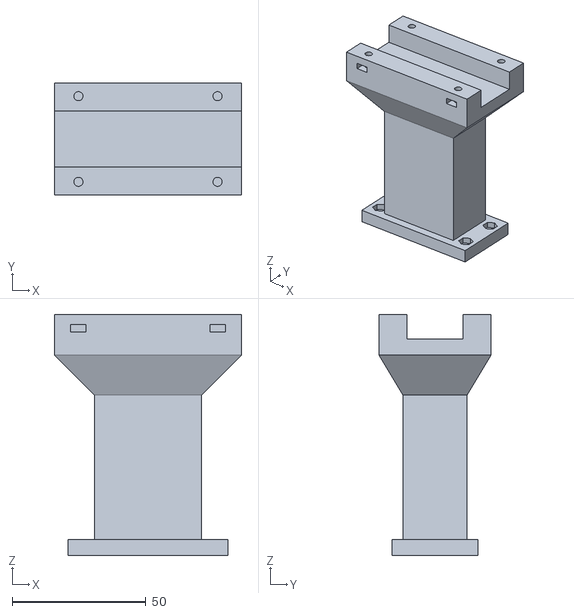
[picture p31: CAD file, 2026-11-10]
parts/print_ready/belt_clamp.stl
70.0 x 42.0 x 90.1
