AjayaDahal/inverted-pendulum/parts/vitamins/kp08_rear.stl

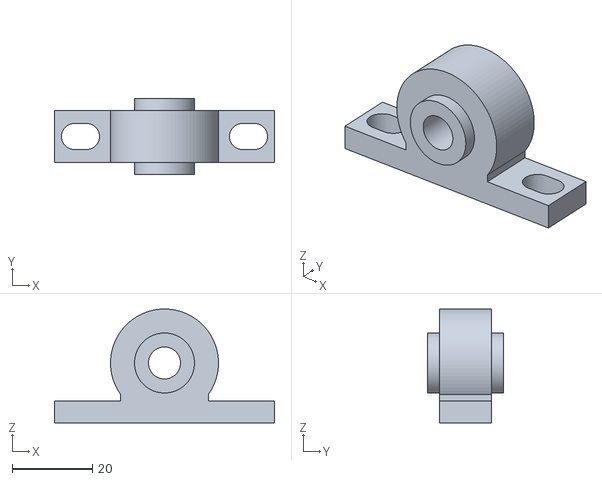
[picture p32: CAD file, 2026-11-08]
parts/vitamins/kp08_rear.stl
55.0 x 19.0 x 28.5
