AjayaDahal/inverted-pendulum/3mf/s1_petg/pendulum_hub.3mf

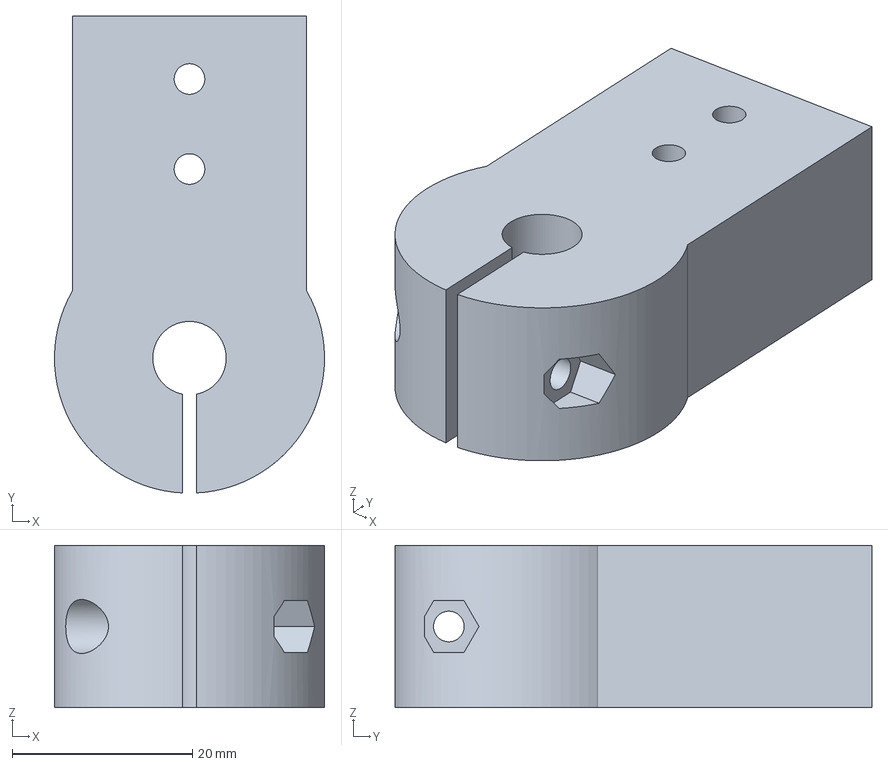
[picture p33: CAD file, 2026-11-10]
3mf/s1_petg/pendulum_hub.3mf
30.0 x 53.0 x 18.0 mm
