AjayaDahal/inverted-pendulum/3mf/s1_petg_plates/petg_2_pulleys_pivot.3mf

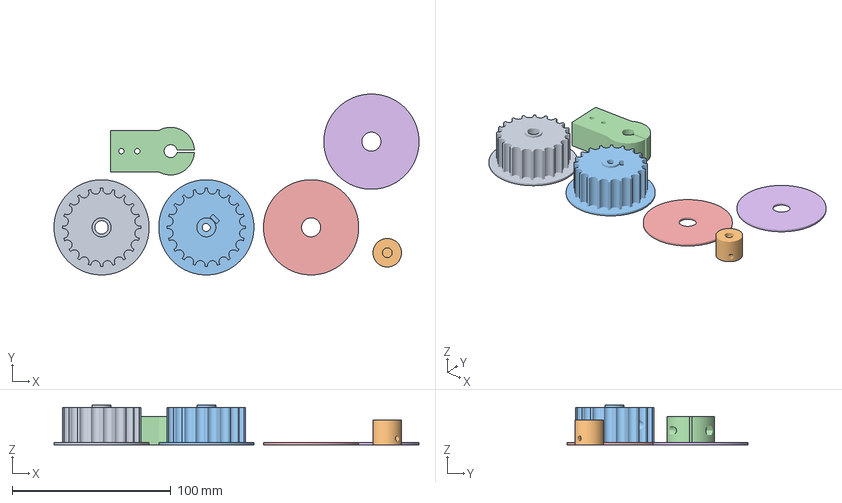
[picture p34: CAD file, 2026-11-10]
3mf/s1_petg_plates/petg_2_pulleys_pivot.3mf
230.0 x 114.0 x 25.0 mm
idler_pulley.stl
magnet_cap.stl
motor_pulley.stl
pendulum_hub.stl
pulley_flange_1.stl
pulley_flange_2.stl
