AjayaDahal/inverted-pendulum/3mf/s1_pla/as5600_mount.3mf

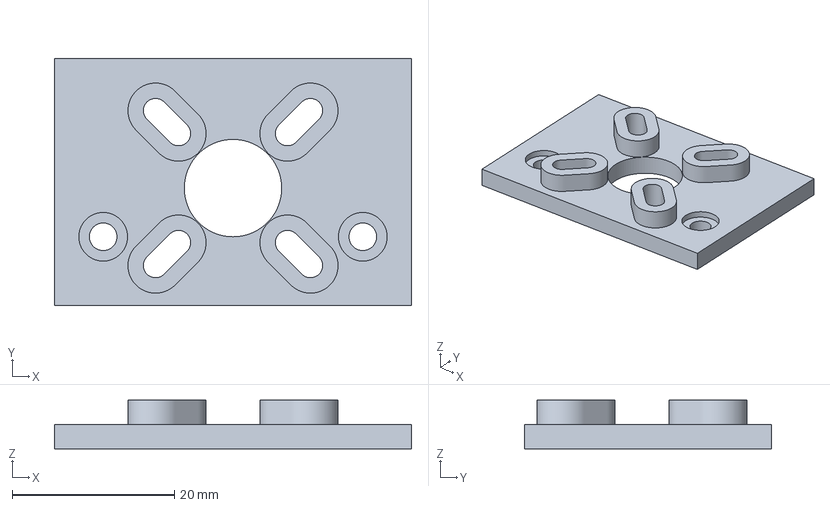
[picture p35: CAD file, 2026-11-10]
3mf/s1_pla/as5600_mount.3mf
44.0 x 30.5 x 6.00 mm
