AjayaDahal/inverted-pendulum/3mf/s1_pla_plates/pla_3_arm.3mf

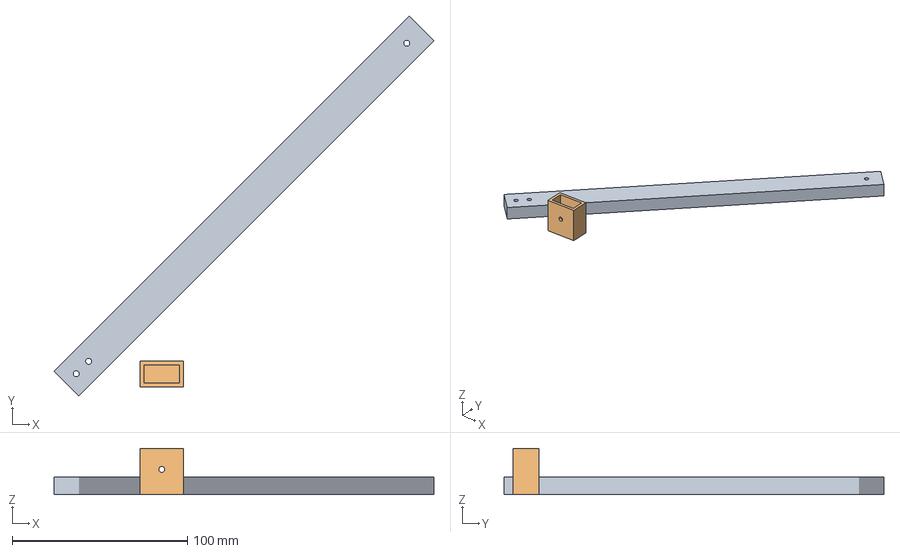
[picture p36: CAD file, 2026-11-10]
3mf/s1_pla_plates/pla_3_arm.3mf
217.1 x 217.1 x 26.4 mm
pendulum_arm.stl
pendulum_tip.stl
