AjayaDahal/inverted-pendulum/parts/print_ready/idler_mount.stl

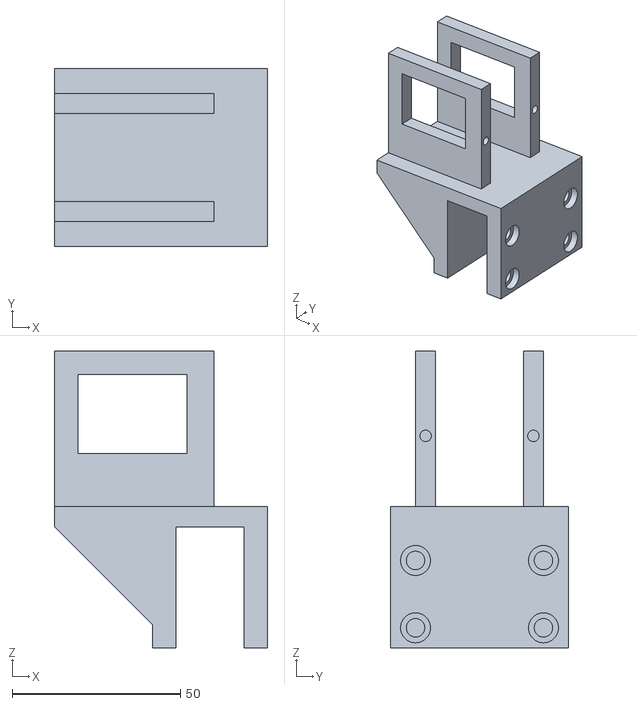
[picture p37: CAD file, 2026-11-10]
parts/print_ready/idler_mount.stl
63.3 x 53.0 x 88.2
