AjayaDahal/inverted-pendulum/parts/vitamins/sc8uu_pb.stl

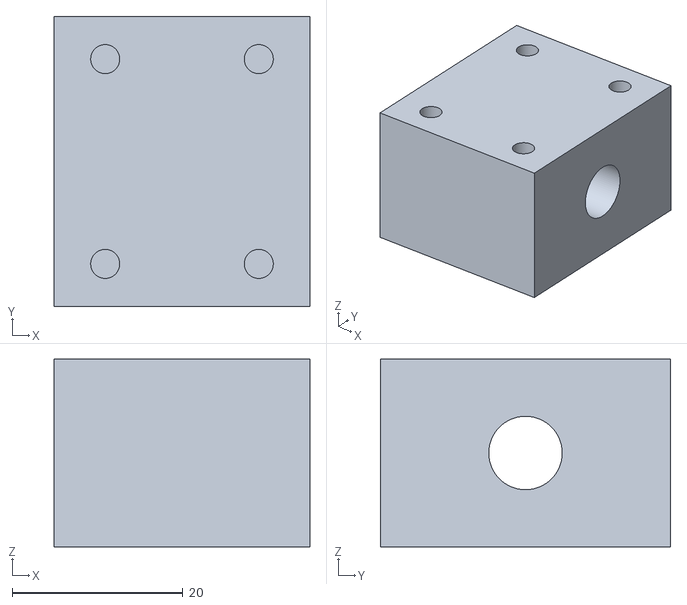
[picture p38: CAD file, 2026-11-08]
parts/vitamins/sc8uu_pb.stl
30.0 x 34.0 x 22.0
