AjayaDahal/inverted-pendulum/3mf/s1_petg/idler_sleeve.3mf

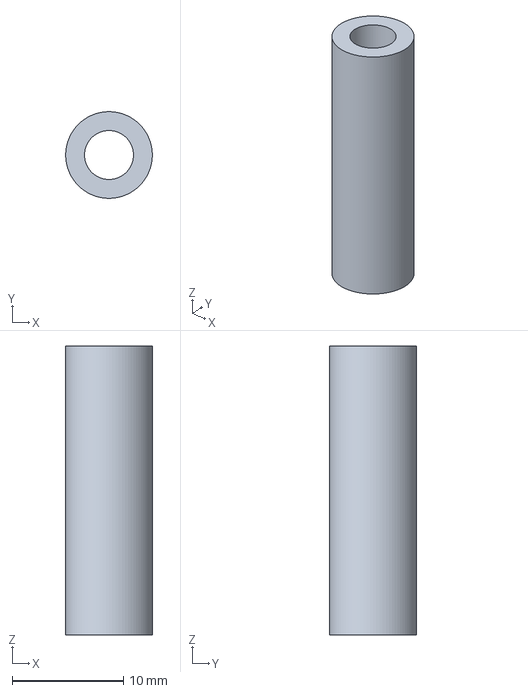
[picture p39: CAD file, 2026-11-10]
3mf/s1_petg/idler_sleeve.3mf
7.80 x 7.80 x 26.0 mm
