AjayaDahal/inverted-pendulum/3mf/s1_pla/switch_mount.3mf

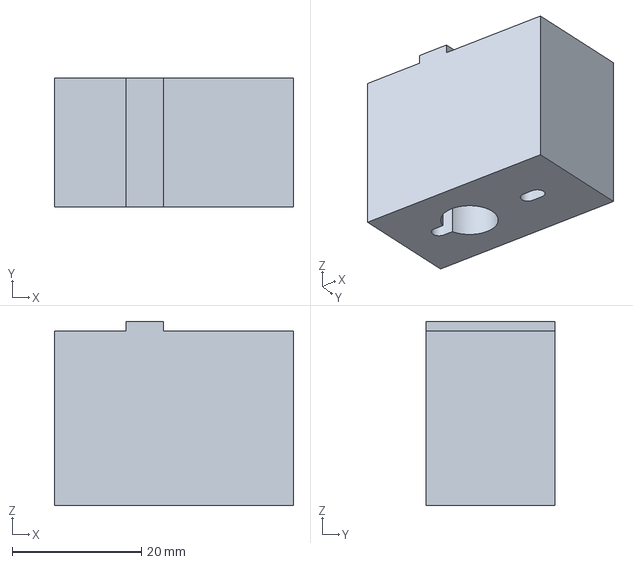
[picture p40: CAD file, 2026-11-10]
3mf/s1_pla/switch_mount.3mf
37.0 x 20.0 x 28.5 mm
