AjayaDahal/inverted-pendulum/parts/vitamins/belt.stl

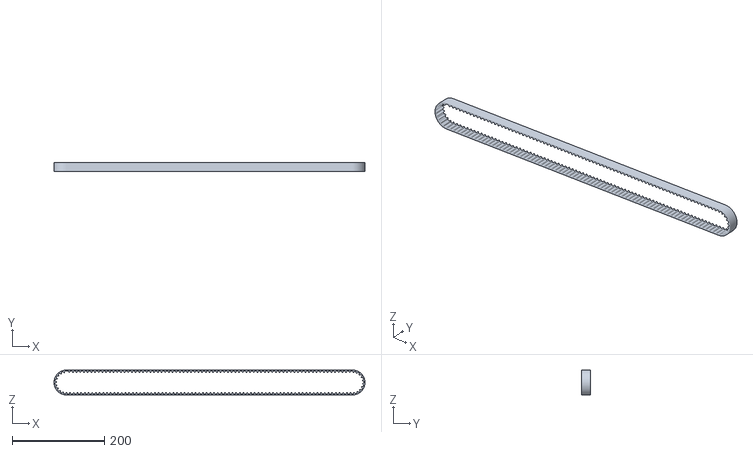
[picture p41: CAD file, 2026-11-08]
parts/vitamins/belt.stl
674.0 x 20.0 x 54.0
