AjayaDahal/inverted-pendulum/3mf/s1_pla/electronics_tray.3mf

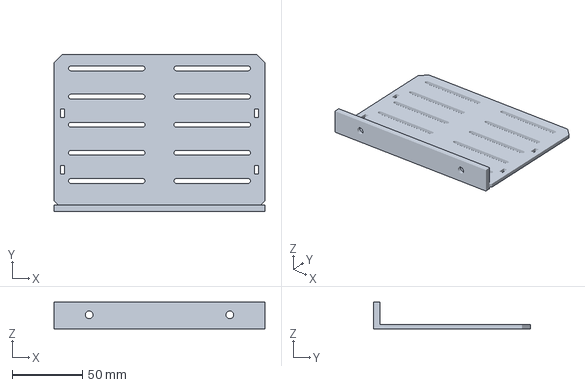
[picture p42: CAD file, 2026-11-10]
3mf/s1_pla/electronics_tray.3mf
150.0 x 111.8 x 19.0 mm
