AjayaDahal/inverted-pendulum/parts/assembly/pivot_bridge.stl

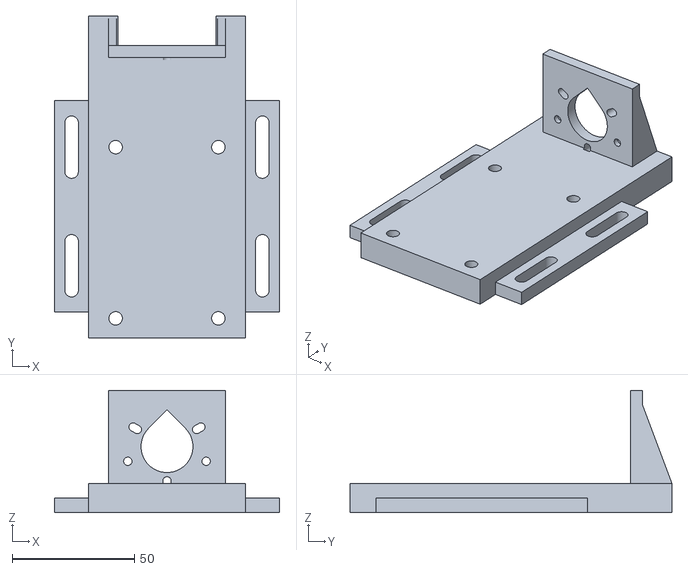
[picture p43: CAD file, 2026-11-08]
parts/assembly/pivot_bridge.stl
92.0 x 131.6 x 50.0
