AjayaDahal/inverted-pendulum/parts/vitamins/lpd3806.stl

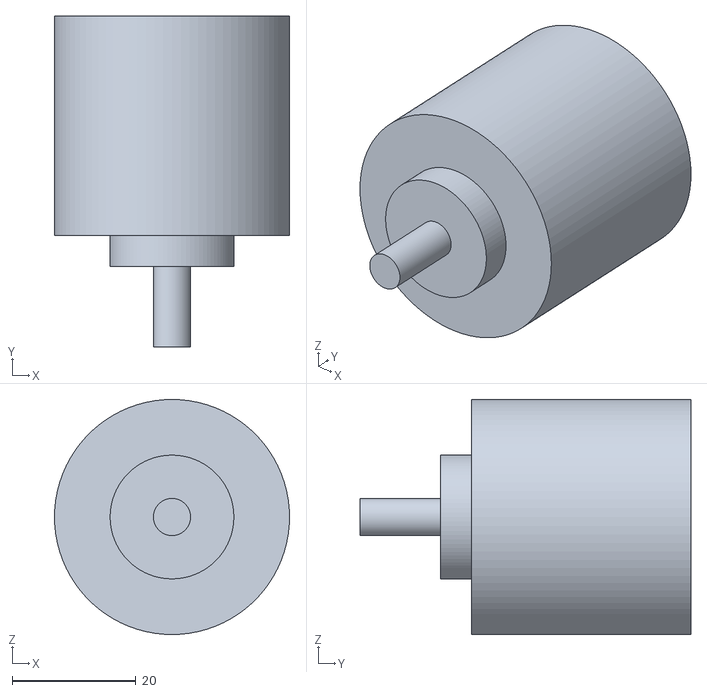
[picture p44: CAD file, 2026-11-08]
parts/vitamins/lpd3806.stl
38.0 x 53.5 x 38.0
