AjayaDahal/inverted-pendulum/3mf/s1_petg/idler_slider.3mf

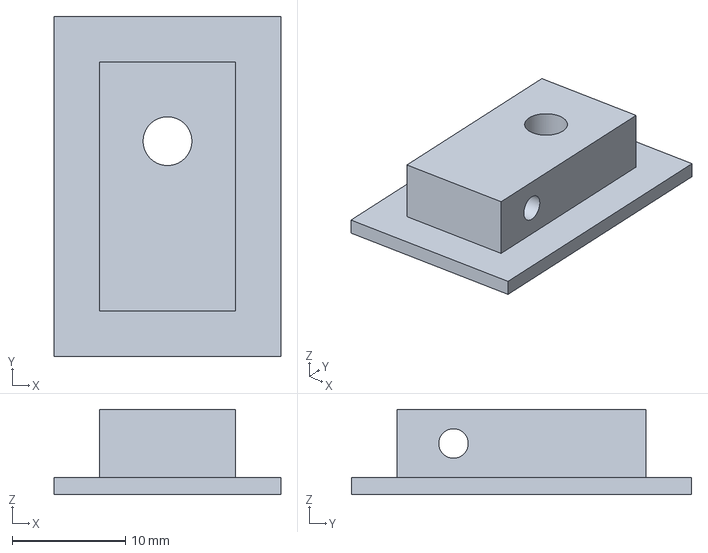
[picture p45: CAD file, 2026-11-10]
3mf/s1_petg/idler_slider.3mf
20.0 x 30.0 x 7.50 mm
