AjayaDahal/inverted-pendulum/3mf/s1_pla/pendulum_tip.3mf

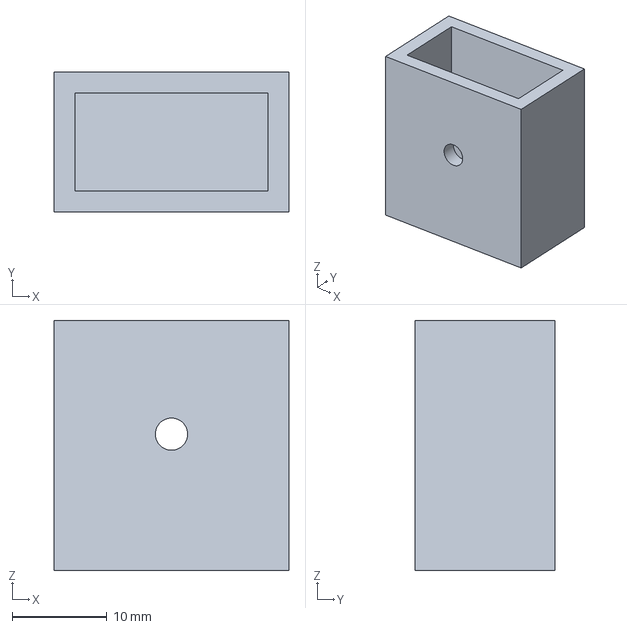
[picture p46: CAD file, 2026-11-10]
3mf/s1_pla/pendulum_tip.3mf
24.8 x 14.8 x 26.4 mm
