AjayaDahal/inverted-pendulum/parts/assembly/rod_bumper.stl

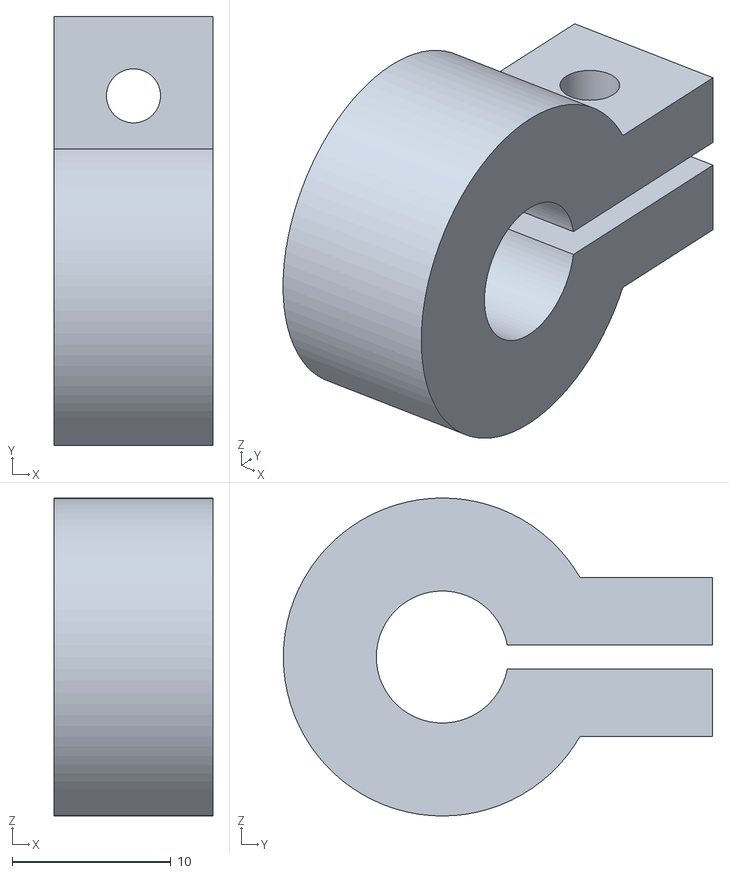
[picture p47: CAD file, 2026-11-08]
parts/assembly/rod_bumper.stl
10.0 x 27.0 x 20.0
