AjayaDahal/inverted-pendulum/3mf/s1_petg/magnet_cap.3mf

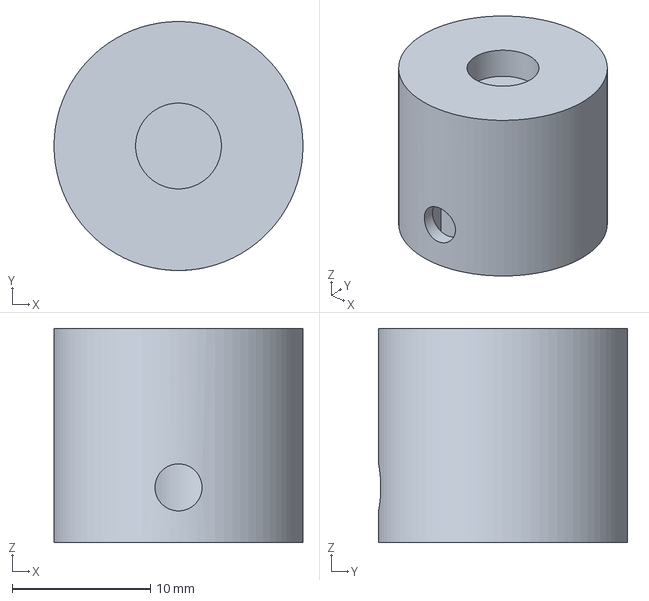
[picture p48: CAD file, 2026-11-10]
3mf/s1_petg/magnet_cap.3mf
18.0 x 18.0 x 15.5 mm
