AjayaDahal/inverted-pendulum/parts/vitamins/endstop_m.stl

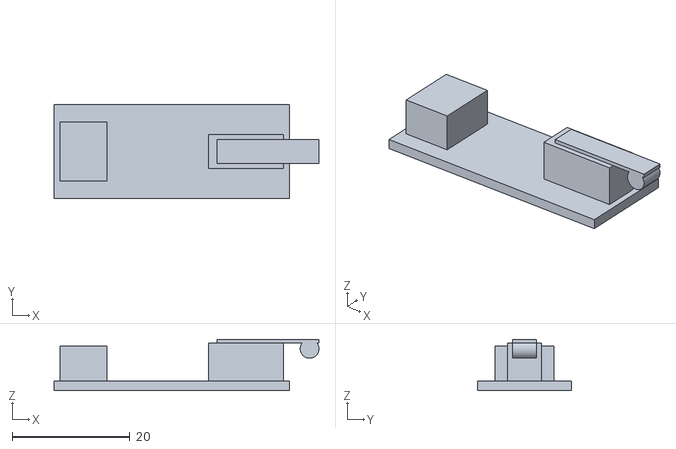
[picture p49: CAD file, 2026-11-08]
parts/vitamins/endstop_m.stl
45.0 x 16.0 x 8.70
