AjayaDahal/inverted-pendulum/parts/vitamins/sk8_pf.stl

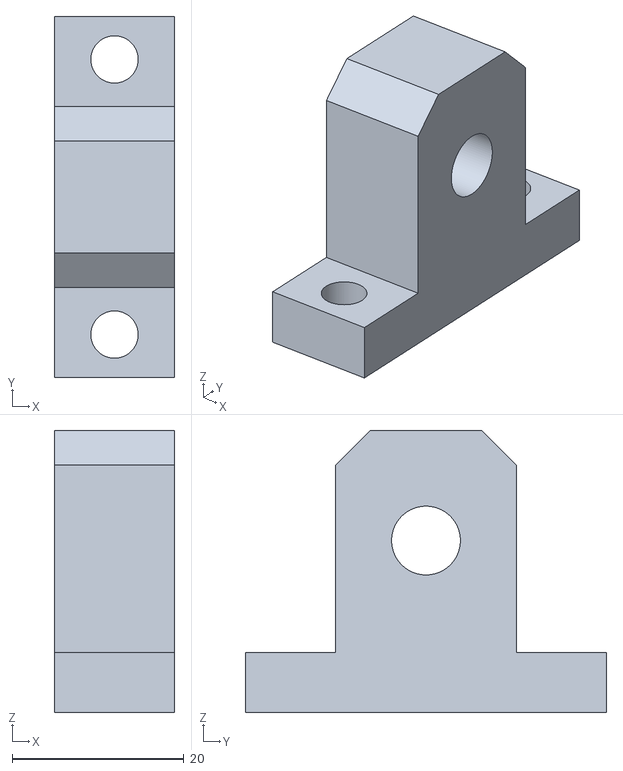
[picture p50: CAD file, 2026-11-08]
parts/vitamins/sk8_pf.stl
14.0 x 42.0 x 32.8
