AjayaDahal/inverted-pendulum/3mf/s1_petg/pulley_flange.3mf

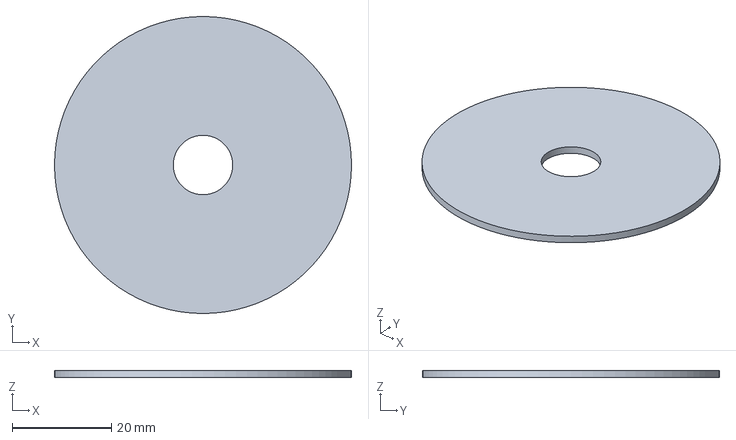
[picture p51: CAD file, 2026-11-10]
3mf/s1_petg/pulley_flange.3mf
60.0 x 60.0 x 1.50 mm
