AjayaDahal/inverted-pendulum/3mf/s1_petg/cable_clip.3mf

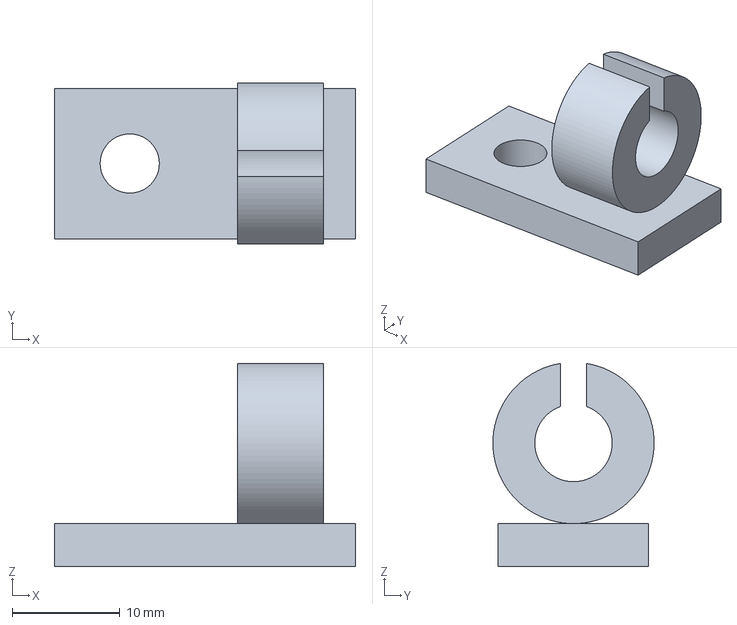
[picture p52: CAD file, 2026-11-10]
3mf/s1_petg/cable_clip.3mf
28.0 x 15.0 x 18.9 mm
