AjayaDahal/inverted-pendulum/parts/vitamins/post_pb.stl

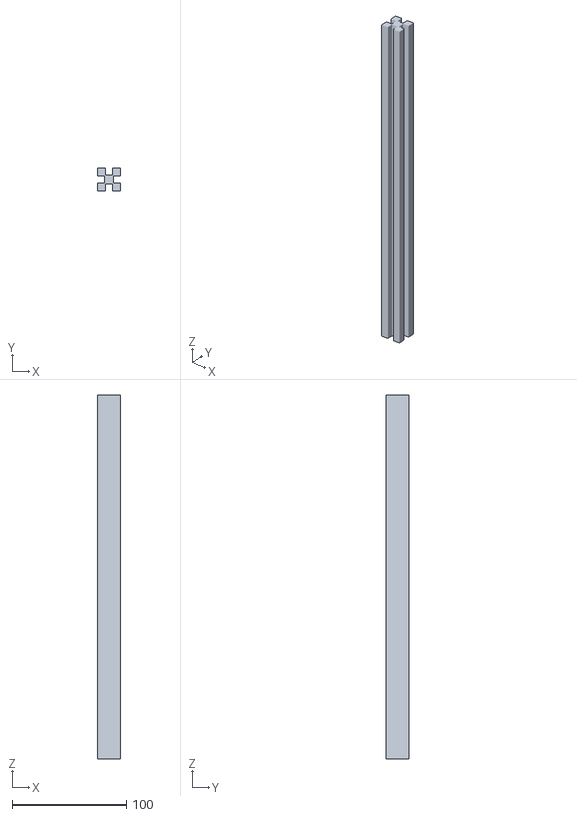
[picture p53: CAD file, 2026-11-08]
parts/vitamins/post_pb.stl
20.0 x 20.0 x 319.0
