AjayaDahal/inverted-pendulum/parts/vitamins/magnet.stl

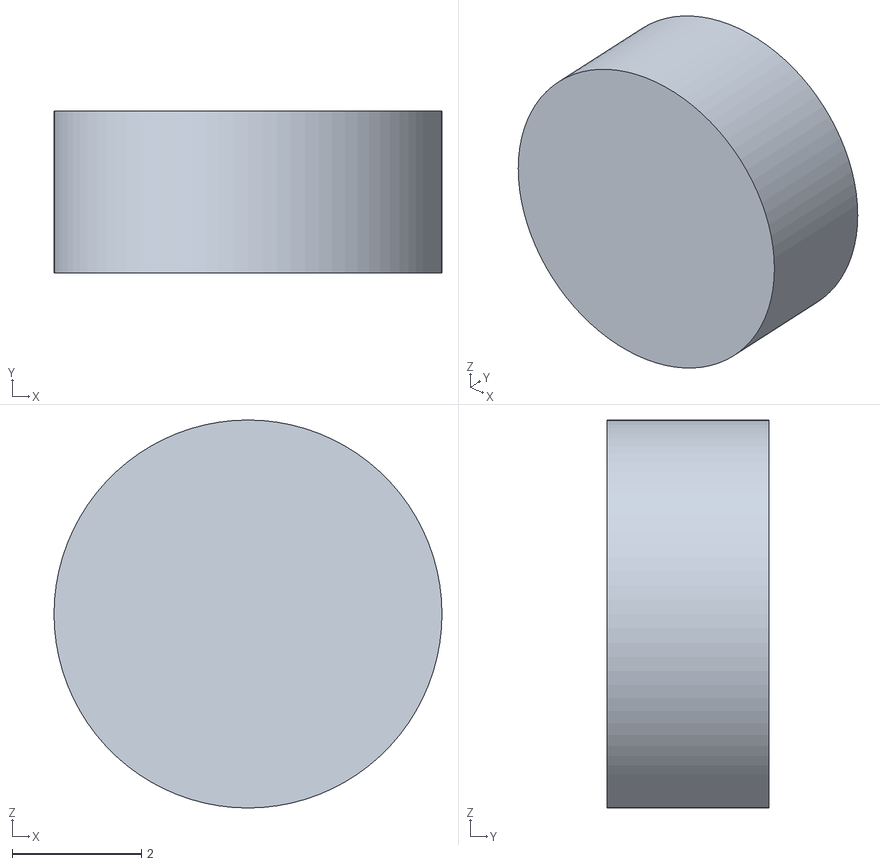
[picture p54: CAD file, 2026-11-08]
parts/vitamins/magnet.stl
6.00 x 2.50 x 6.00
