AjayaDahal/inverted-pendulum/parts/as_built/hex_key.stl

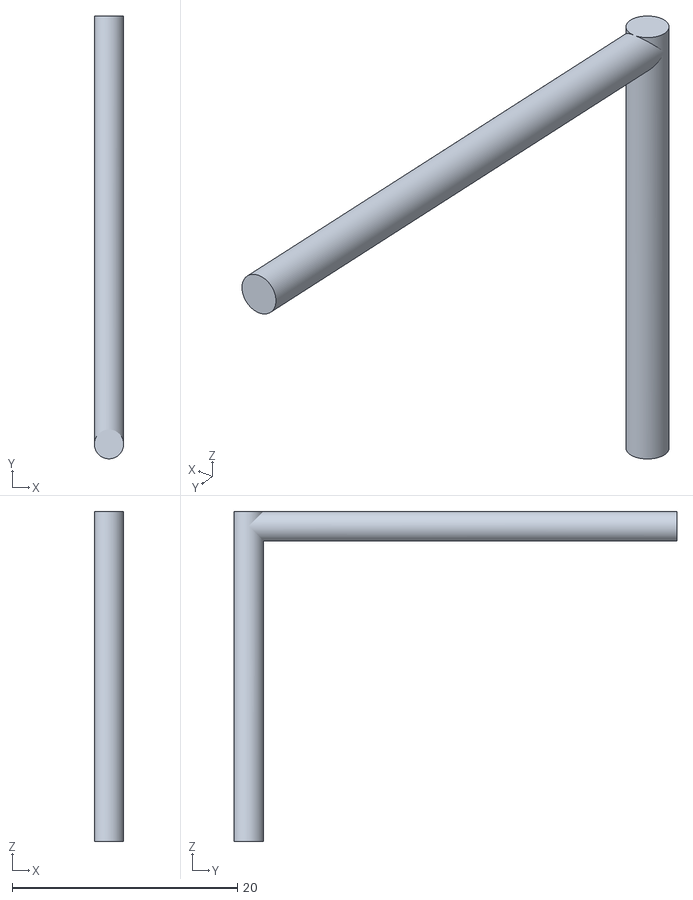
[picture p55: CAD file, 2026-11-05]
parts/as_built/hex_key.stl
2.60 x 39.3 x 29.3
