AjayaDahal/inverted-pendulum/parts/assembly/pendulum_arm.stl

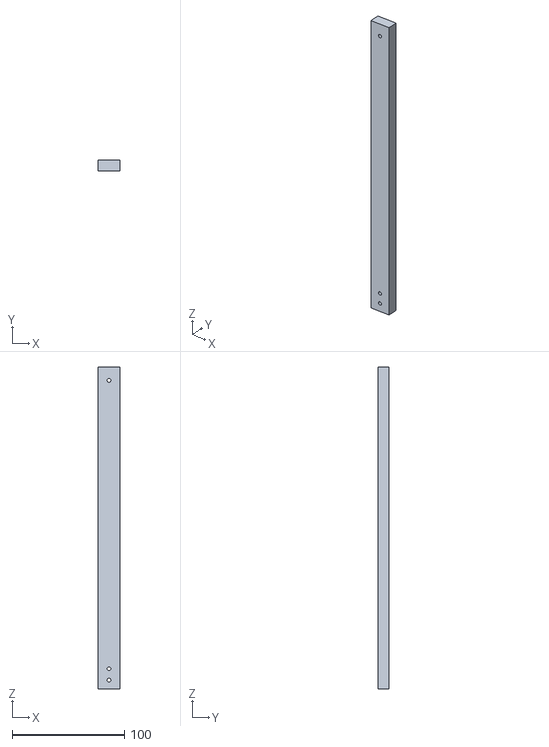
[picture p56: CAD file, 2026-11-08]
parts/assembly/pendulum_arm.stl
20.0 x 10.0 x 287.0
