AjayaDahal/inverted-pendulum/parts/vitamins/top_bar_m.stl

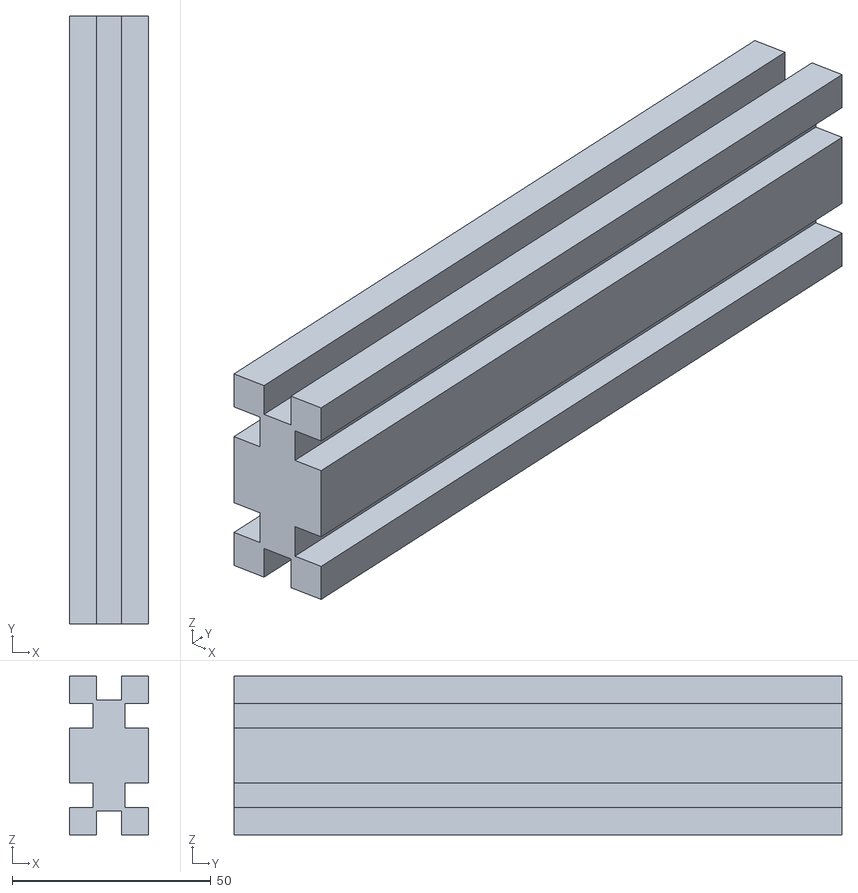
[picture p57: CAD file, 2026-11-08]
parts/vitamins/top_bar_m.stl
20.0 x 153.0 x 40.0
