AjayaDahal/inverted-pendulum/parts/vitamins/pivot_shaft.stl

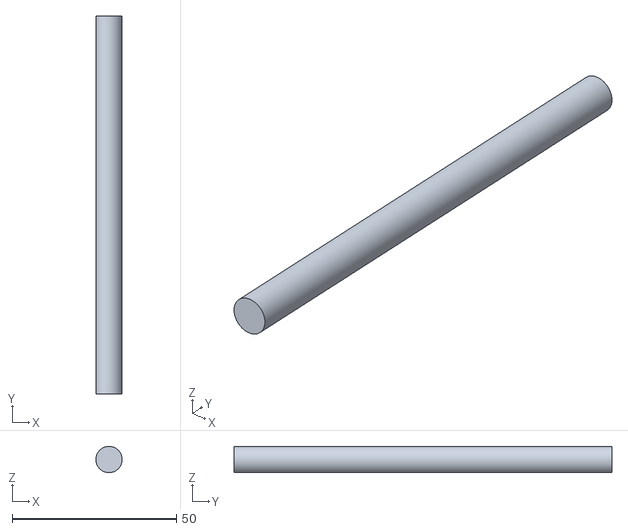
[picture p58: CAD file, 2026-11-08]
parts/vitamins/pivot_shaft.stl
8.00 x 115.0 x 8.00
