AjayaDahal/inverted-pendulum/parts/vitamins/nema17.stl

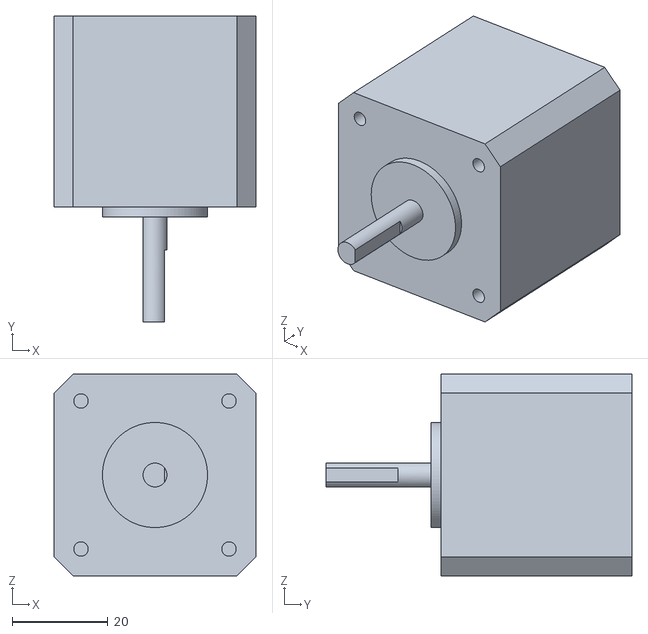
[picture p59: CAD file, 2026-11-08]
parts/vitamins/nema17.stl
42.3 x 64.0 x 42.3
