AjayaDahal/inverted-pendulum/parts/vitamins/as5600.stl

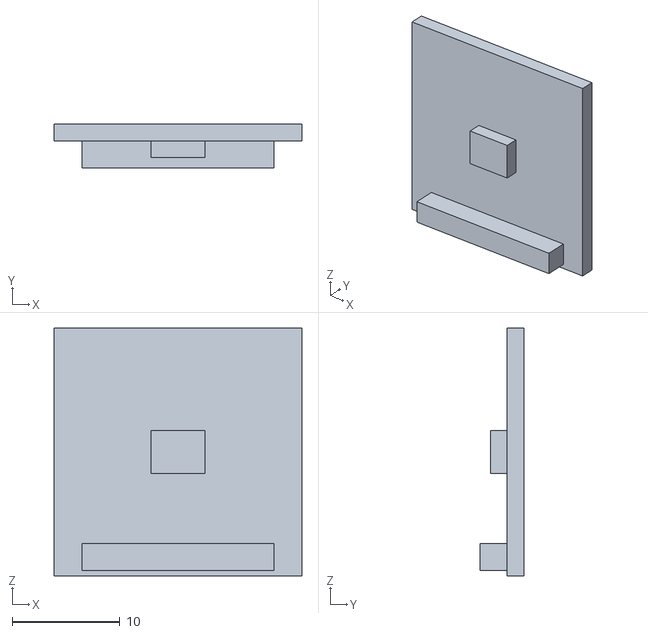
[picture p60: CAD file, 2026-11-08]
parts/vitamins/as5600.stl
23.0 x 4.10 x 23.0
