AjayaDahal/inverted-pendulum/parts/vitamins/long_f.stl

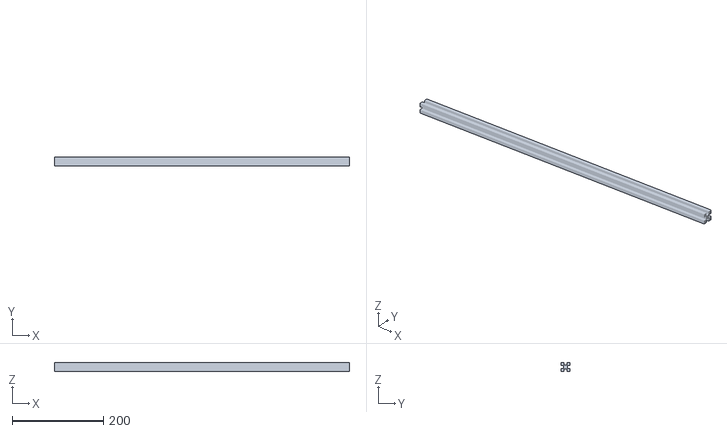
[picture p61: CAD file, 2026-11-06]
parts/vitamins/long_f.stl
646.0 x 20.0 x 20.0
