AjayaDahal/inverted-pendulum/parts/vitamins/controller.stl

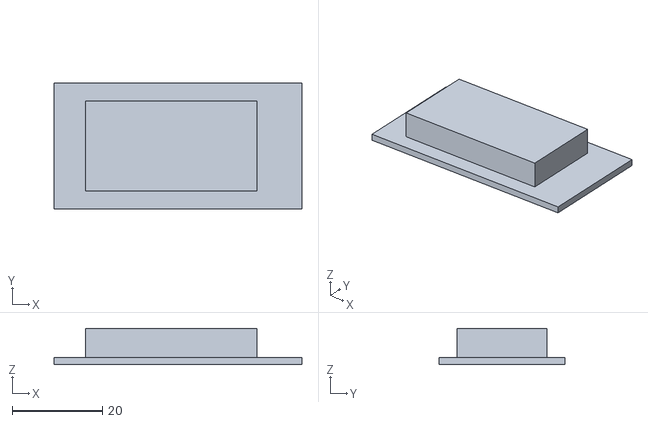
[picture p62: CAD file, 2026-11-06]
parts/vitamins/controller.stl
55.0 x 28.0 x 8.00
