AjayaDahal/inverted-pendulum/parts/vitamins/driver_board.stl

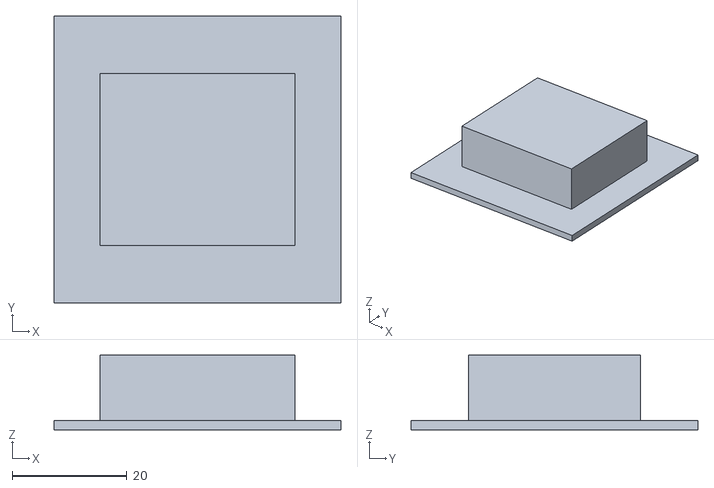
[picture p63: CAD file, 2026-11-06]
parts/vitamins/driver_board.stl
50.0 x 50.0 x 13.0
