AjayaDahal/inverted-pendulum/parts/vitamins/bottom_bar_p.stl

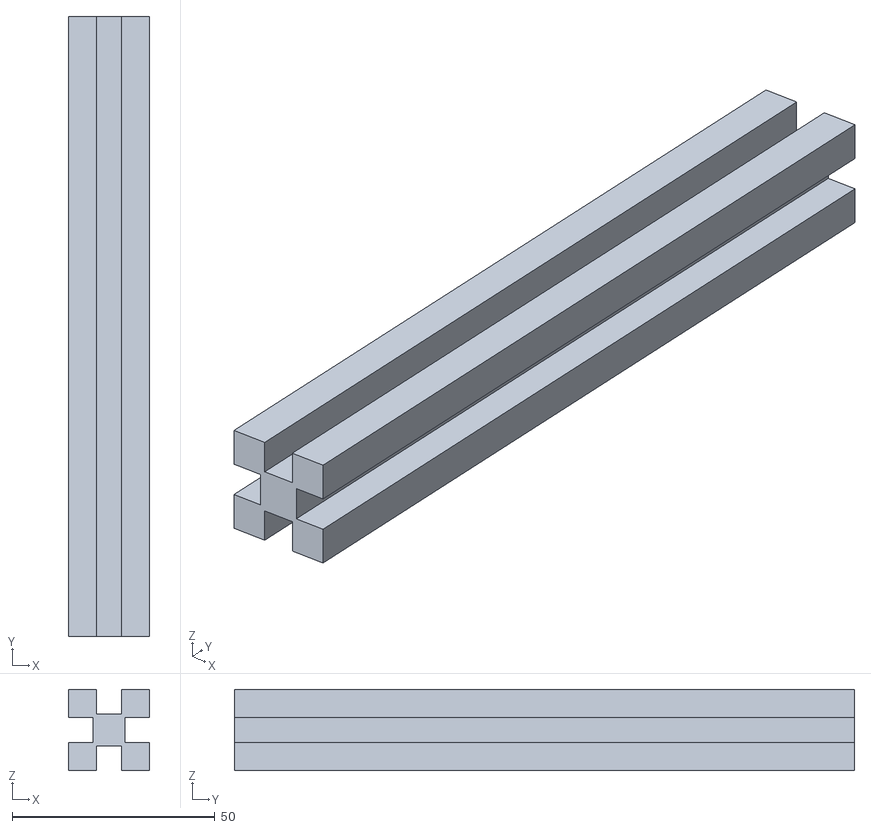
[picture p64: CAD file, 2026-11-06]
parts/vitamins/bottom_bar_p.stl
20.0 x 153.0 x 20.0
