AjayaDahal/inverted-pendulum/(list of files, cad)

Other CAD files:
3mf/s1_pla_plates/pla_1_carriage_plate.3mf
parts/assembly/carriage_plate.stl
parts/print_ready/carriage_plate.stl
parts/assembly/belt_clamp.stl
parts/assembly/idler_mount.stl
parts/print_ready/motor_mount.stl
3mf/s1_petg/idler_mount.3mf
3mf/s1_pla/belt_clamp.3mf
parts/assembly/pendulum_hub.stl
parts/print_ready/pendulum_hub.stl
parts/vitamins/sc8uu_pf.stl
3mf/s1_petg/motor_pulley.3mf
parts/print_ready/coupler.stl
parts/print_ready/idler_sleeve.stl
parts/vitamins/rod_b.stl
3mf/s1_pla/pivot_bridge.3mf
parts/assembly/coupler.stl
parts/print_ready/idler_slider.stl
parts/vitamins/sc8uu_mf.stl
3mf/s1_petg/motor_mount.3mf
parts/assembly/pendulum_tip.stl
parts/print_ready/pendulum_arm.stl
3mf/s1_petg/coupler.3mf
parts/assembly/magnet_cap.stl
parts/print_ready/pivot_bridge.stl
parts/assembly/clamp_jaw.stl
parts/print_ready/switch_mount.stl
parts/vitamins/endstop_p.stl
parts/assembly/as5600_mount.stl
parts/print_ready/idler_pulley.stl
3mf/s1_petg/rod_bumper.3mf
parts/assembly/idler_slider.stl
parts/print_ready/motor_pulley.stl
parts/print_ready/rod_bumper.stl
parts/assembly/idler_sleeve.stl
parts/print_ready/pendulum_tip.stl
parts/assembly/switch_mount.stl
parts/print_ready/electronics_tray.stl
parts/vitamins/sk8_mf.stl
parts/assembly/pulley_flange.stl
parts/print_ready/magnet_cap.stl
parts/vitamins/top_bar_p.stl
parts/assembly/electronics_tray.stl
parts/print_ready/clamp_jaw.stl
parts/vitamins/post_mf.stl
parts/assembly/cable_clip.stl
parts/print_ready/pulley_flange.stl
parts/vitamins/kp08_front.stl
parts/assembly/motor_pulley.stl
parts/print_ready/as5600_mount.stl
parts/vitamins/sk8_pb.stl
parts/assembly/idler_pulley.stl
parts/print_ready/cable_clip.stl
parts/vitamins/post_mb.stl
parts/vitamins/sk8_mb.stl
parts/vitamins/sc8uu_mb.stl
parts/vitamins/post_pf.stl
parts/vitamins/long_b.stl
parts/vitamins/bottom_bar_m.stl
parts/as_built/old_bar.stl
parts/as_built/old_belt.stl
parts/as_built/old_idler_bracket.stl
parts/as_built/old_idler_pulley.stl
parts/as_built/old_idler_rod.stl
parts/as_built/old_kp08_front.stl
parts/as_built/old_kp08_rear.stl
parts/as_built/old_motor.stl
parts/as_built/old_motor_bracket.stl
parts/as_built/old_motor_pulley.stl
parts/as_built/old_plate.stl
parts/as_built/old_switch_arm.stl
parts/as_built/old_wedge.stl
