AjayaDahal/inverted-pendulum/(commit log)

2026-11-05 Inverted pendulum v1: parametric design, gate, viewer and docs
    build123d scripts for 21 printed parts around the owner's frame, rods, bearings, motor and belt; a model of the machine as built with nine findings; the verification gate; the cart-pole simulation; slicer pipeline and profiles for the Kobra S1; three.js viewer; README, DESIGN, REPORT, BOM, SLICING, tracker.
    [machine_kobra_s1.json]
2026-11-05 Parts: printed and print-ready STLs, bought parts, the machine as built, STEP, assembly and simulation data
    [as5600.stl, as5600_mount.stl, belt.stl, belt_clamp.stl, bottom_bar_m.stl, bottom_bar_p.stl, cable_clip.stl, carriage_plate.stl]
2026-11-05 Renders, animations and the slicer projects (every part and plate, two complete projects)
    [as5600_mount.3mf, belt_clamp.3mf, cable_clip.3mf, carriage_plate.3mf, clamp_jaw.3mf, complete_project_kobra_s1_petg.3mf, complete_project_kobra_s1_pla.3mf, coupler.3mf]
2026-11-05 Gate: report failed checks as GitHub annotations; state the force budget plainly
    [check_parts.py]
2026-11-05 Plates: platform-independent layout
    Round parts have exactly tied orientations (45/135 deg); last-bit differences in cos/sin between Windows and Linux picked different ones, so CI saw petg_2_pulleys_pivot as stale. Rotations are rounded to 1e-6 mm, candidates compared on rounded values, and the grid test rounds its distances. Checked identical on Windows and Linux (numpy 2.4.6); plate re-sliced.
    [complete_project_kobra_s1_petg.3mf, petg_2_pulleys_pivot.3mf]
2026-11-05 Renders: print plates with the new layout; AGENTS note on cross-platform results
2026-11-05 Premortem: what else could make the machine fail, and the fixes
    REPORT.md gains a premortem (P1-P16): each cause checked with numbers, most in the
    simulation, which now models them.
    - Motor force: torque-speed model at the driver's 1.5 A and 19 V, 80 % relied on, against the
    motion plus the friction at the cart (rails, belt, the idler's greased plain journal at 15 N
    belt tension); the acceleration limit (4.68 m/s^2) comes out of that budget.
    - Controller rewritten (sim.Controller): kick from rest, a velocity-form energy pump (bounded
    cart travel), a catch on the divergent mode, LQR with integral action (upright calibration
    error), delay 8-20 ms, pivot friction to 2.5 mN m, AS5600 or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
    [as5600.stl, as5600_mount.stl, coupler.stl, inverted_pendulum_v1.step, lpd3806.stl, magnet.stl, magnet_cap.stl, pivot_bridge.stl]
2026-11-05 Renders: sensor tower behind the magnet spacer, swing-up from rest with the new controller
2026-11-05 G-code and 3MF: magnet cap, coupler, AS5600 mount and their PETG plates, re-sliced for the magnet spacer
    [as5600_mount.3mf, complete_project_kobra_s1_petg.3mf, coupler.3mf, magnet_cap.3mf, petg_2_pulleys_pivot.3mf, petg_3_option_encoder.3mf]
2026-11-05 G-code and 3MF: pivot bridge and its PLA plate, re-sliced
    [complete_project_kobra_s1_pla.3mf, pivot_bridge.3mf, pla_2_bridge_clamp_tray.3mf]
2026-11-06 Rebuild to the measured machine: frame 686 x 193, rods 114 apart, closed HTD 8M belt
    The owner's measuring photos (tape and calipers) showed the model's frame, rods and belt were
    wrong (REPORT.md, M1-M4). Rebuilt to them:
    - Frame 686 x 193 mm (height still 300, an estimate: O1), rods 114 mm apart (SC8UU holes slotted
    +-8: 98-130 fit), rods at least 680 mm. Plate narrows to 160 mm; the pendulum's plane moves back
    with the frame's front face; bridge bolts and switch blocks moved clear of the SK8s.
    - Belt: HTD 8M, 20 mm, a closed loop. New BELT_TEETH (175 assumed, count it: O2) sets the axles'
    spacing; both pulleys (20 teeth, 160 mm per turn, 20 steps/mm) sit symmetric, 23 mm inboard of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
    [as5600.stl, as5600_mount.3mf, as5600_mount.stl, belt.stl, belt_clamp.3mf, belt_clamp.stl, bottom_bar_m.stl, bottom_bar_p.stl]
2026-11-06 Renders: the machine as measured (686 x 193 frame, HTD 8M drive, longer travel)
2026-11-06 G-code: PETG parts for the measured machine (8M pulleys, mounts, jaw)
2026-11-06 G-code: PLA parts for the measured machine (plate, bridge, clamp)
2026-11-06 G-code: PETG plates for the measured machine
2026-11-06 G-code: PLA plates for the measured machine
2026-11-08 Third photo set: belt of 180 teeth, idler axle M4, one project of the parts still to print
    Photos of 2026-11-08 (kept private): the belt laid flat, the idler off the machine on its axle.
    - Belt: 180 teeth (1440 mm), counted from the tooth pattern's phase round the unwrapped loop in
    two photos (180.4; 180.0-181.0). It was assumed 175, which put the axles 20 mm closer than
    the tensioner's +-10 mm can reach. BELT_TEETH 180: axles 640 mm apart, both mounts 10 mm out.
    REPORT M5; O2 now "confirm by hand".
    - Idler: 20-tooth 8M with two flanges, on two ~1.7 mm rods taped together (REPORT M6, A1 and A4
    corrected, as-built model redrawn). As a cantilever those rods yield at 2-7 N; a taut belt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
    [belt.stl, complete_project_kobra_s1_petg.3mf, idler_mount.3mf, idler_mount.stl, idler_sleeve.3mf, idler_sleeve.stl, idler_slider.3mf, idler_slider.stl]
2026-11-08 Renders: 180-tooth belt (axles 640 mm apart), as-built idler on its two thin rods
2026-11-08 To-print project: stamp the presets' parsed JSON, so a CRLF checkout (core.autocrlf on Windows) does not read it as stale
    [to_print_kobra_s1.3mf]
2026-11-08 Closed belt: tension it with the idler, and fit it before the idler's axle and the motor pulley's front flange
    The assembly order was written for an open belt: with the motor pulley's front flange on and the
    idler's axle through (cheeks, web and axle make a ring), a closed loop cannot go on. The 100 g
    check now counts only the extra sag (the run's own weight sags it 4 mm) on the 640 mm run: 10 mm
    for 15 N (200 g: 21 mm); re-check after the first hour. REPORT M3 notes it.
2026-11-08 Belt 175 teeth (the owner's count; stamped 1400 mm), parts print without supports, 3MF beds grouped by material
    - BELT_TEETH back to 175: the owner counted it, and it is stamped 1400 mm at 8 mm pitch. The
    photo count of 180 was wrong (about 3 % off round a loop in perspective): REPORT M5 says so,
    O2 is closed, AGENTS warns against counting teeth from a photo. Axles 620 mm apart again.
    - The owner's slicer flagged the idler mount ("floating cantilever"). A layer-by-layer audit of
    every print-ready part found three that printed in mid-air with supports off (REPORT G7):
    - idler_mount: its web reached 29 mm in from the saddle: a 45 deg gusset now holds it, and the
    saddle bolts throug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
    [belt.stl, belt_clamp.3mf, belt_clamp.stl, complete_project_kobra_s1_petg.3mf, complete_project_kobra_s1_pla.3mf, coupler.3mf, coupler.stl, idler_mount.3mf]
2026-11-08 Renders: belt back to 175 teeth, the idler mount's gusset and outer-face bolts, the clamp's four-sided flare
2026-11-08 Frame height 319 mm (the owner's tape), closing O1
    - FRAME_H 319 (was the 300 estimate): read from his photo with the tape's hook on the desk,
    against an end bar (the bar's top 0.8 mm under the 32 cm line). Two photos with the tape 50 mm
    in front of a rod read its axis ~10 mm high, as parallax from above makes it (REPORT O1).
    - Everything rises 19 mm: rods 339, pulleys 242, pivot 385; the tip clears the desk by 83 mm.
    No printed part changes shape.
    - make_print_ready keeps a part's file when its surface is unchanged: the CAD kernel reorders and
    re-splits the triangles of a part that only moves, which made 14 unchanged parts' G-code look
    stale. Same vertices (1 um), volume and area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
    [as5600.stl, as5600_mount.stl, belt.stl, belt_clamp.stl, carriage_plate.stl, clamp_jaw.stl, coupler.stl, endstop_m.stl]
2026-11-08 Renders: the frame at its measured 319 mm
2026-11-10 Print audit: inner walls first, stairs over pockets, sag room, brims, one project
    - Process presets print inner walls first, as the installed slicer's stock
    Kobra S1 preset does: outer walls first laid a hole's walls in mid-air over
    the pocket below, the thrust stand's crank fault, in six parts (REPORT R1).
    - pendulum_hub and belt_clamp start their holes over the arm socket and the
    jaw-nut slots in two one-layer steps, so each layer bridges between held edges.
    - BRIDGE_SAG room under bridged fits (idler windows, hub socket); SADDLE_FIT
    on the end mounts' saddles.
    - A 5 mm brim on every part taller than the square root of its first layer's
    area; plates keep their gap from the brims.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
    [as5600_mount.3mf, belt_clamp.3mf, belt_clamp.stl, cable_clip.3mf, carriage_plate.3mf, clamp_jaw.3mf, complete_project_kobra_s1.3mf, complete_project_kobra_s1_petg.3mf]
2026-11-10 Renders: the parts after the print audit (sag room, saddle fit, stairs, brims)
2026-11-10 G-code: PETG plates re-sliced
2026-11-10 G-code: PLA plates re-sliced
2026-11-11 Carriage plate: orientation marks; hardware numbers to measure (R12, R13)
    The first carriage plate did not go on its SC8UU blocks. The premortem
    checked printing, not fit to the owner's hardware: the plate's hole
    pattern is the catalogue's, never measured, and nothing on the nearly
    square plate showed which way it goes on (the owner's photo shows it
    turned 90 degrees, slots along a rod).
    - carriage_plate: a line engraved over each rod and an arrow to the front.
    - DESIGN.md "Measure first": the catalogue sizes the printed parts depend
    on (SC8UU holes, SK8/SC8UU heights, KP08 bolts and height, switch board).
    - tracker.md: measure, or print the part's first 2 mm, before the carriage
    plate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
    [carriage_plate.3mf, carriage_plate.stl, complete_project_kobra_s1.3mf, inverted_pendulum_v1.step, pla_1_carriage_plate.3mf, to_print_kobra_s1.3mf]
2026-11-11 CI: apt only if build123d cannot load; back to ubuntu-latest
    The gate never ran: apt-get on GitHub's runners could not resolve Ubuntu's
    package mirrors (azure.archive, archive, security.ubuntu.com) on 26.04 and,
    pinned, on 24.04 too: an outage, not the image (the 11-08 pass was on 26.04).
    That image already has libgl1, libxrender1 and libxext6, and apt only added
    libglu1-mesa and libopengl0, so install the libraries only when importing
    build123d fails, with apt retries. Undo the 24.04 pin.
